CreativeInquiry/SCI-RAT-Attachments-for-UR5/README.md

# SCI-RAT-Attachments-for-UR5
A series of 3D-printable attachments for the UR5 robot arm, developed by the Frank Ratchye STUDIO for Creative Inquiry.

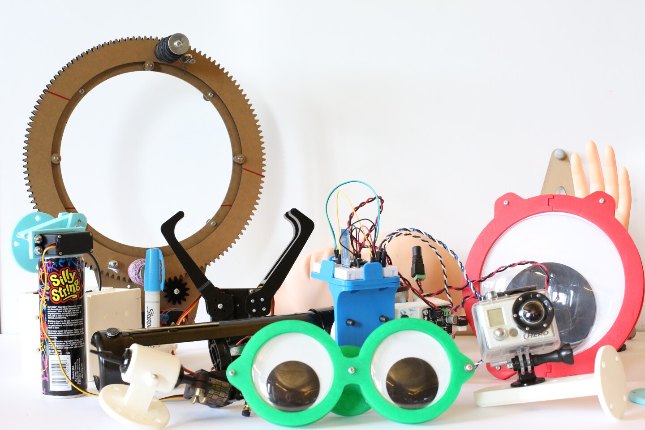
[picture p1: Images/lo_SCI-RAT.jpg]
Image of 15 Attachments


The following files are included for every adapter:
  * [.3dm] The original CAD files made in Rhino.
  * [.stl] Compatible with various 3D printing sofware.
  * [.x3g] Machine instructions for Makerbot Replicator 2.

All files are licensed under the [CC BY-SA 4.0 License](https://creativecommons.org/licenses/by-sa/4.0/).

Here is a full list of all attachments in this repository so far:

1. **Universal Mounts:**
  * [Rod Adapter](https://github.com/johnchoi313/SCI-RAT-Attachments-for-UR5/tree/master/Attachments/Universal%20Mounts/Rod%20Adapter)
  * [Camera Mount](https://github.com/johnchoi313/SCI-RAT-Attachments-for-UR5/tree/master/Attachments/Universal%20Mounts/Camera%20Mount)
2. **Electronics Platforms:**
  * [Breadboard Mount](https://github.com/johnchoi313/SCI-RAT-Attachments-for-UR5/tree/master/Attachments/Electronics%20Platforms/Breadboard%20Mount)
  * [Enclosed Arduino Cube](https://github.com/johnchoi313/SCI-RAT-Attachments-for-UR5/tree/master/Attachments/Electronics%20Platforms/Enclosed%20Arduino%20Cube)
3. **Googly Eyes:** 
  * [Googly Eye Double Mount](https://github.com/johnchoi313/SCI-RAT-Attachments-for-UR5/tree/master/Attachments/Googly%20Eyes)
  * [Googly Eye Single Mount](https://github.com/johnchoi313/SCI-RAT-Attachments-for-UR5/tree/master/Attachments/Googly%20Eyes)
4. **Tool Adapters:**
  * [Ryobi Caulk Gun Adapter](https://github.com/johnchoi313/SCI-RAT-Attachments-for-UR5/tree/master/Attachments/Tool%20Adapters/Ryobi%20Caulk%20Gun%20Adapter)
  * [Silly String Adapter](https://github.com/johnchoi313/SCI-RAT-Attachments-for-UR5/tree/master/Attachments/Tool%20Adapters/Silly%20String%20Adapter)
  * [Tattoo Adapter](https://github.com/johnchoi313/SCI-RAT-Attachments-for-UR5/tree/master/Attachments/Tool%20Adapters/Tattoo%20Adapter)
5. **Custom Hardware:**
  * [Threading Machine](https://github.com/johnchoi313/SCI-RAT-Attachments-for-UR5/tree/master/Attachments/Custom%20Hardware/Threading%20Hand)
  * [Gripper Mount](https://github.com/johnchoi313/SCI-RAT-Attachments-for-UR5/tree/master/Attachments/Custom%20Hardware/Gripper%20Mount)
  * [CV Effector](https://github.com/johnchoi313/SCI-RAT-Attachments-for-UR5/tree/master/Attachments/Custom%20Hardware/CV%20Effector)
6. **Body Parts:**
  * [Finger Mount](https://github.com/johnchoi313/SCI-RAT-Attachments-for-UR5/tree/master/Attachments/Body%20Parts/FingerMount)
  * [Hand Mount](https://github.com/johnchoi313/SCI-RAT-Attachments-for-UR5/tree/master/Attachments/Universal%20Mounts/Rod%20Adapter)
  * [Head Mount](https://github.com/johnchoi313/SCI-RAT-Attachments-for-UR5/tree/master/Attachments/Body%20Parts/Head%20Mount)

Detailed documentation of each attachment can be found in this [PDF Document](https://github.com/johnchoi313/SCI-RAT-Attachments-for-UR5/blob/master/SCI-RAT%20Adapters%202016.pdf).
