CreativeInquiry/SCI-RAT-Attachments-for-UR5/Attachments/Miscellaneous/Microscope Project/Microscope Slider.JPG

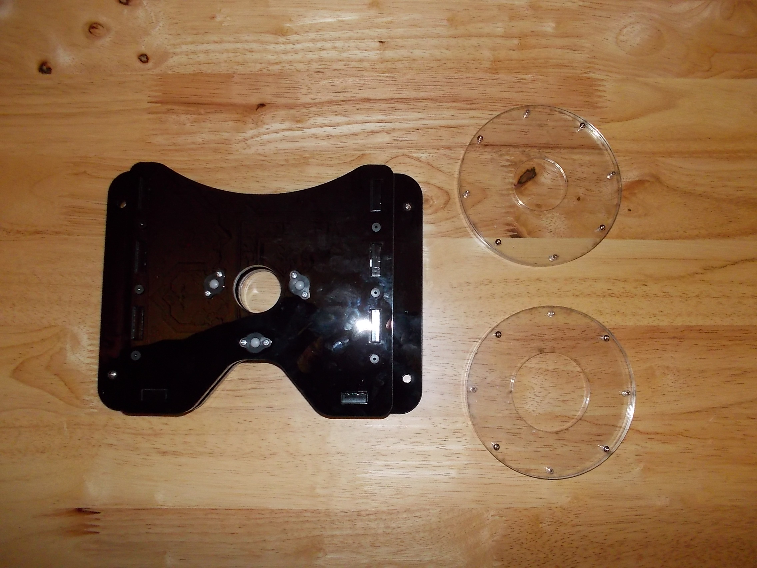
Attachments/Miscellaneous/Microscope Project/Microscope Slider.JPG
