CreativeInquiry/SCI-RAT-Attachments-for-UR5/Images/4x40.PNG

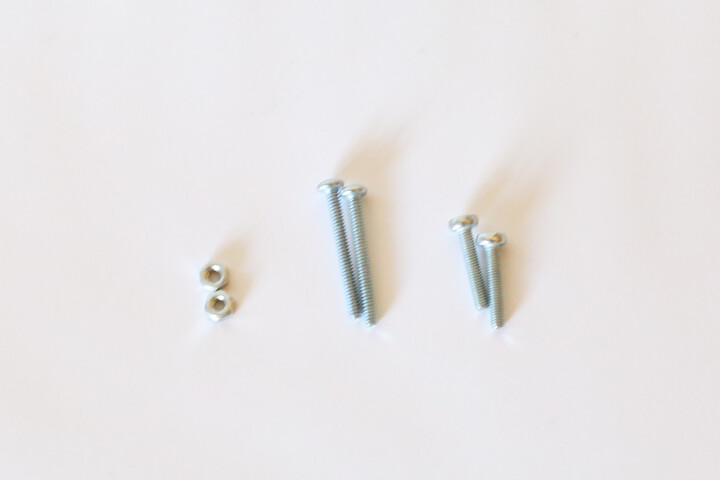
Images/4x40.PNG
