CreativeInquiry/SCI-RAT-Attachments-for-UR5/Images/lo_4-40.jpg

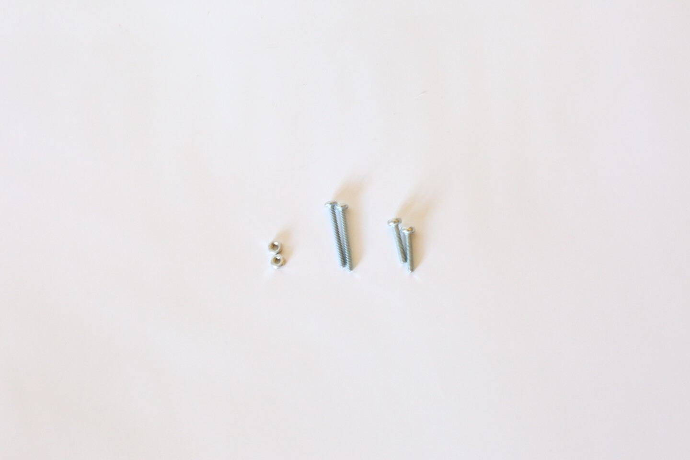
Images/lo_4-40.jpg
