CreativeInquiry/SCI-RAT-Attachments-for-UR5/Images/lo_ArduinoEnclosed (1).jpg

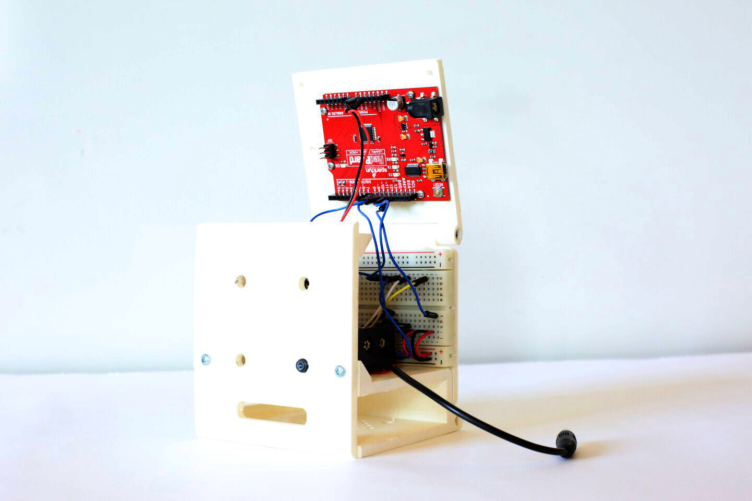
Images/lo_ArduinoEnclosed (1).jpg
