CreativeInquiry/SCI-RAT-Attachments-for-UR5/Images/lo_ArduinoEnclosed (2).jpg

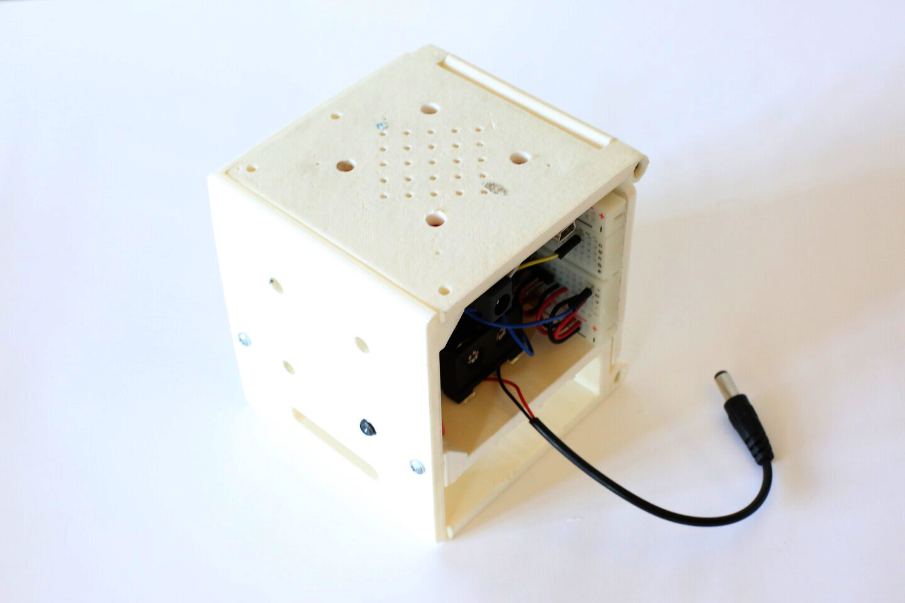
Images/lo_ArduinoEnclosed (2).jpg
