CreativeInquiry/SCI-RAT-Attachments-for-UR5/Images/lo_ArduinoEnclosed (5).jpg

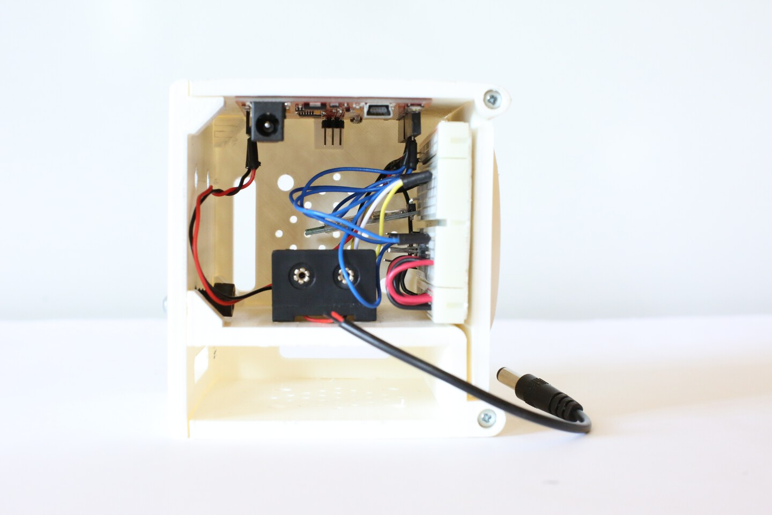
Images/lo_ArduinoEnclosed (5).jpg
