CreativeInquiry/SCI-RAT-Attachments-for-UR5/Images/lo_Breadboard (1).jpg

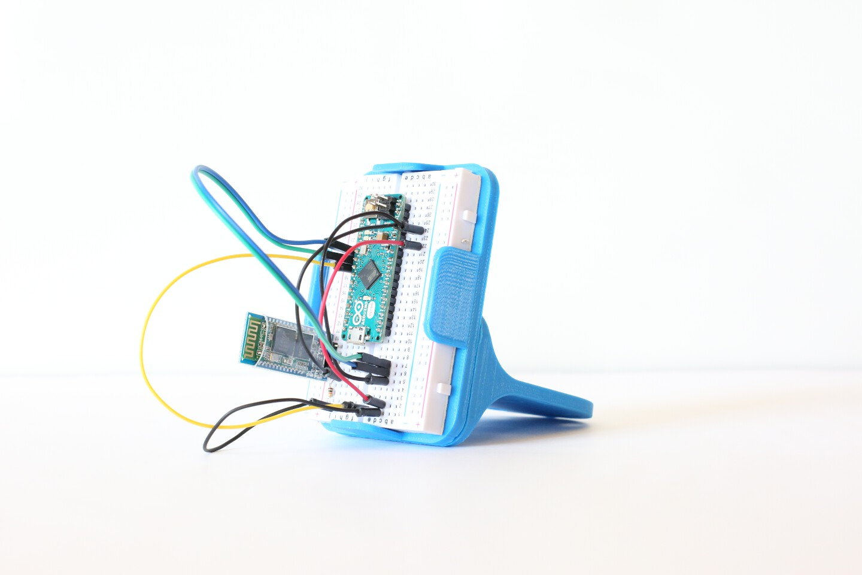
Images/lo_Breadboard (1).jpg
