CreativeInquiry/SCI-RAT-Attachments-for-UR5/Images/lo_Breadboard (2).jpg

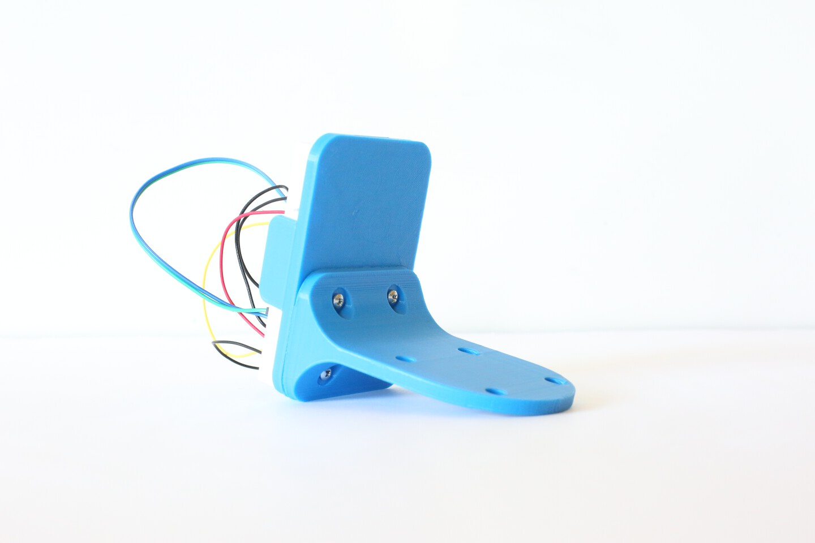
Images/lo_Breadboard (2).jpg
