CreativeInquiry/SCI-RAT-Attachments-for-UR5/Images/lo_Camera (1).jpg

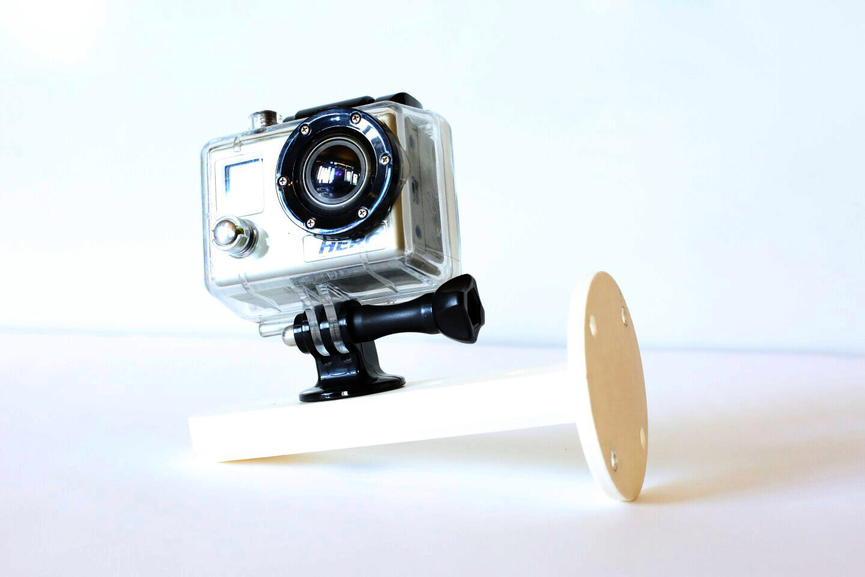
Images/lo_Camera (1).jpg
