CreativeInquiry/SCI-RAT-Attachments-for-UR5/Images/lo_Camera (2).jpg

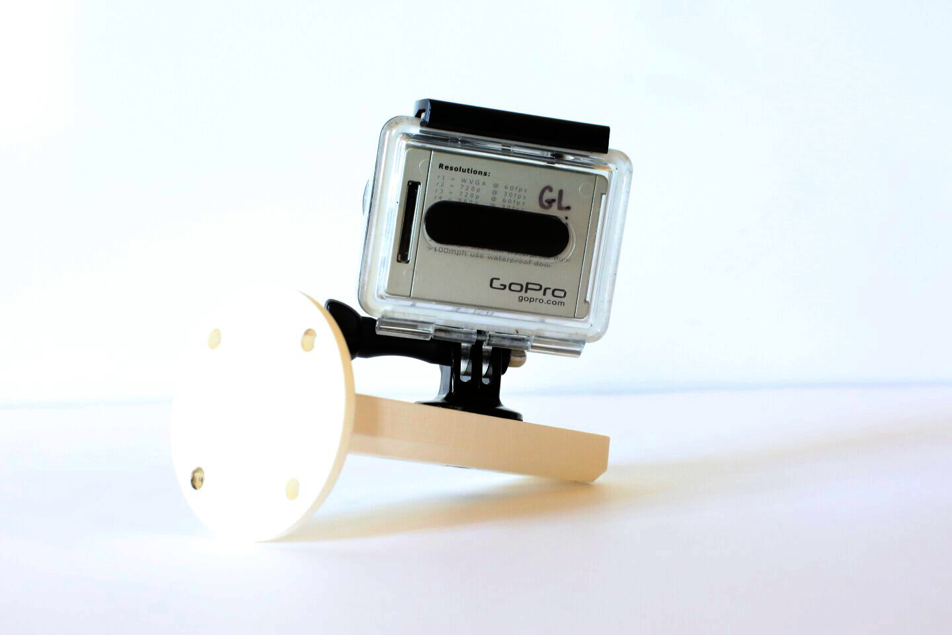
Images/lo_Camera (2).jpg
