CreativeInquiry/SCI-RAT-Attachments-for-UR5/Images/lo_CV (1).jpg

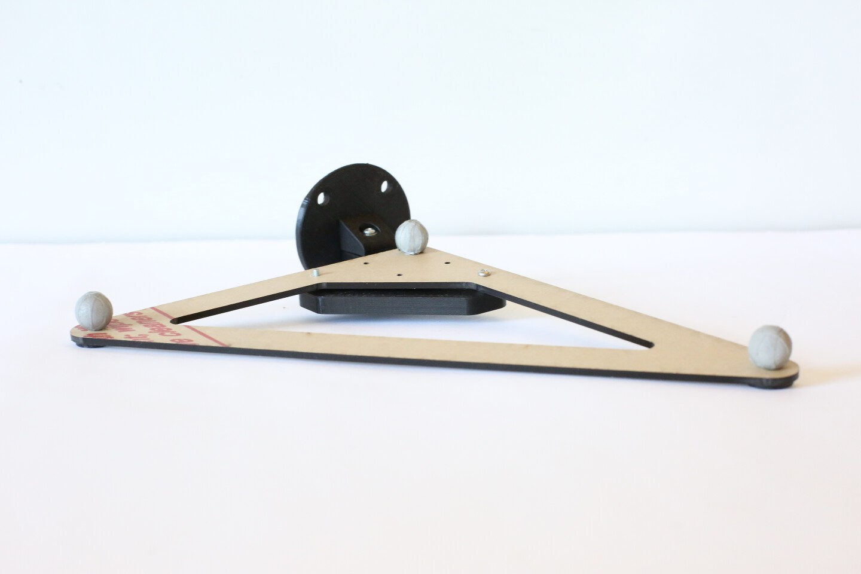
Images/lo_CV (1).jpg
