CreativeInquiry/SCI-RAT-Attachments-for-UR5/Images/lo_GooglyDouble (1).jpg

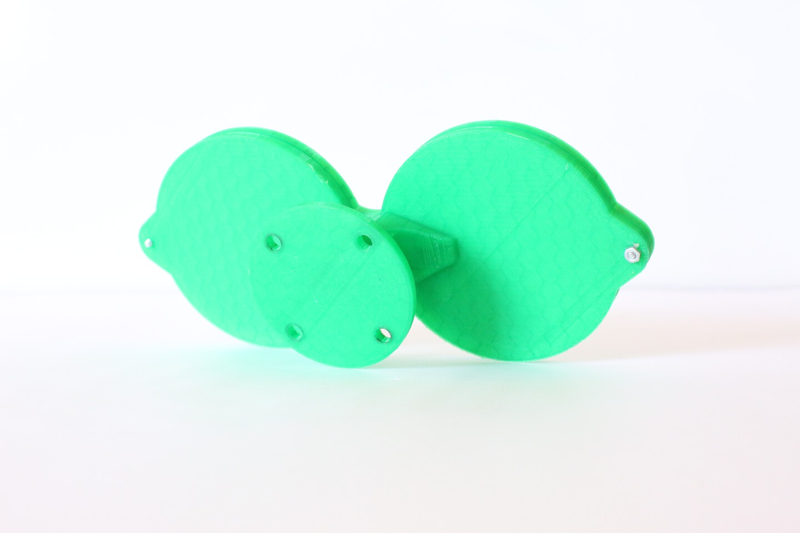
Images/lo_GooglyDouble (1).jpg
