CreativeInquiry/SCI-RAT-Attachments-for-UR5/Images/lo_GooglyDouble (2).jpg

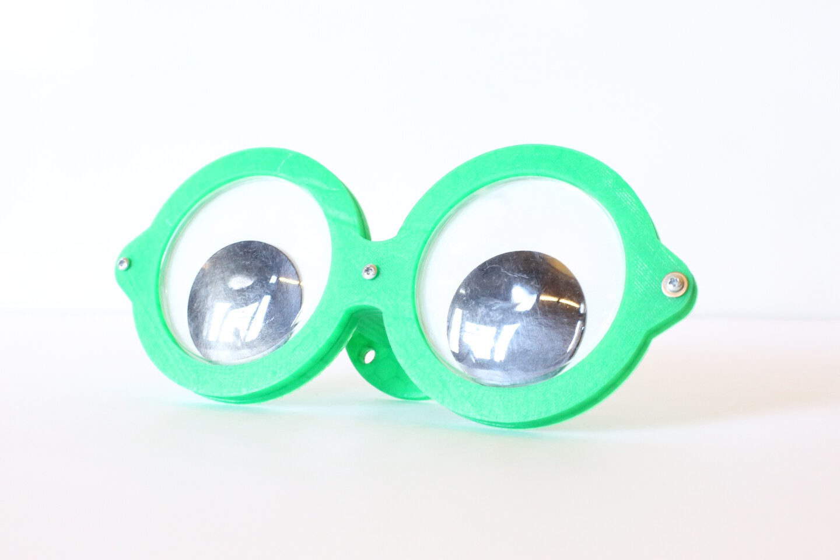
Images/lo_GooglyDouble (2).jpg
