CreativeInquiry/SCI-RAT-Attachments-for-UR5/Images/lo_GooglySingle (2).jpg

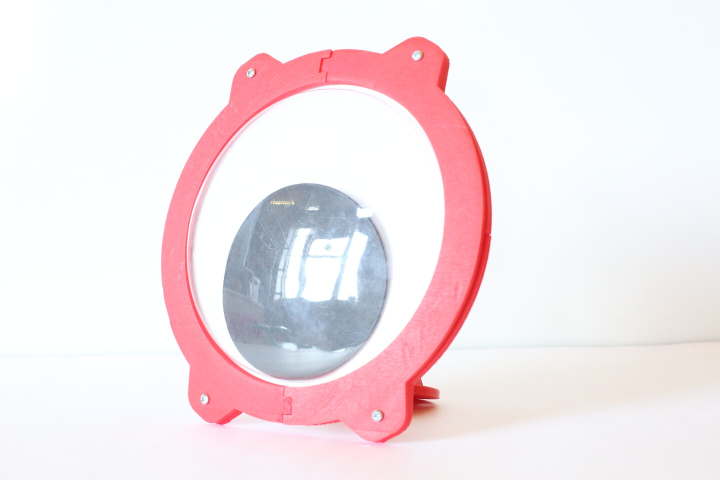
Images/lo_GooglySingle (2).jpg
