CreativeInquiry/SCI-RAT-Attachments-for-UR5/Images/lo_GooglyVR (3).jpg

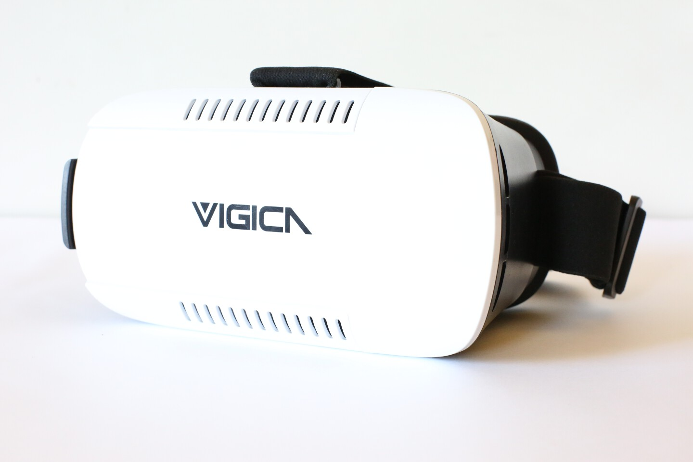
Images/lo_GooglyVR (3).jpg
