CreativeInquiry/SCI-RAT-Attachments-for-UR5/Images/lo_GooglyVR (4).jpg

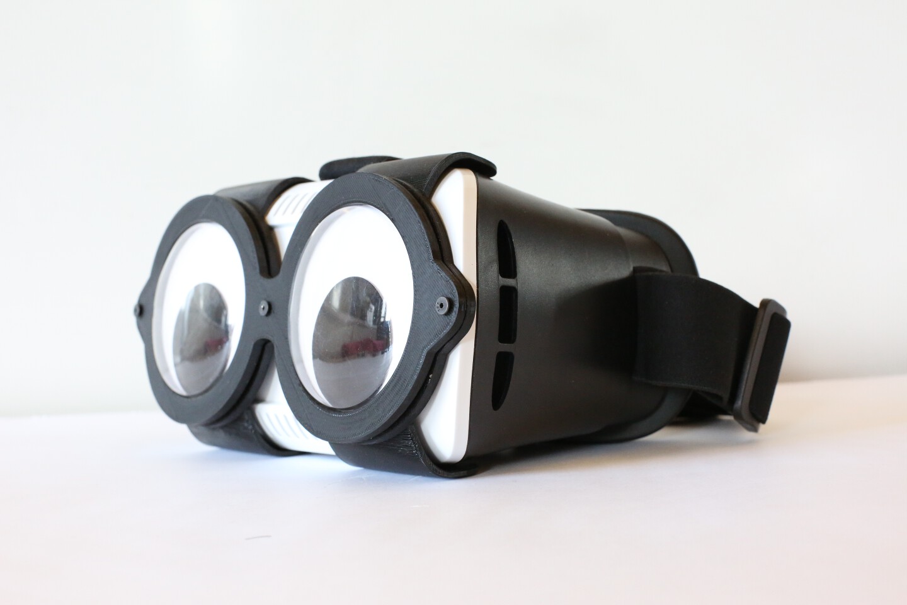
Images/lo_GooglyVR (4).jpg
