CreativeInquiry/SCI-RAT-Attachments-for-UR5/Images/lo_Gripper (1).jpg

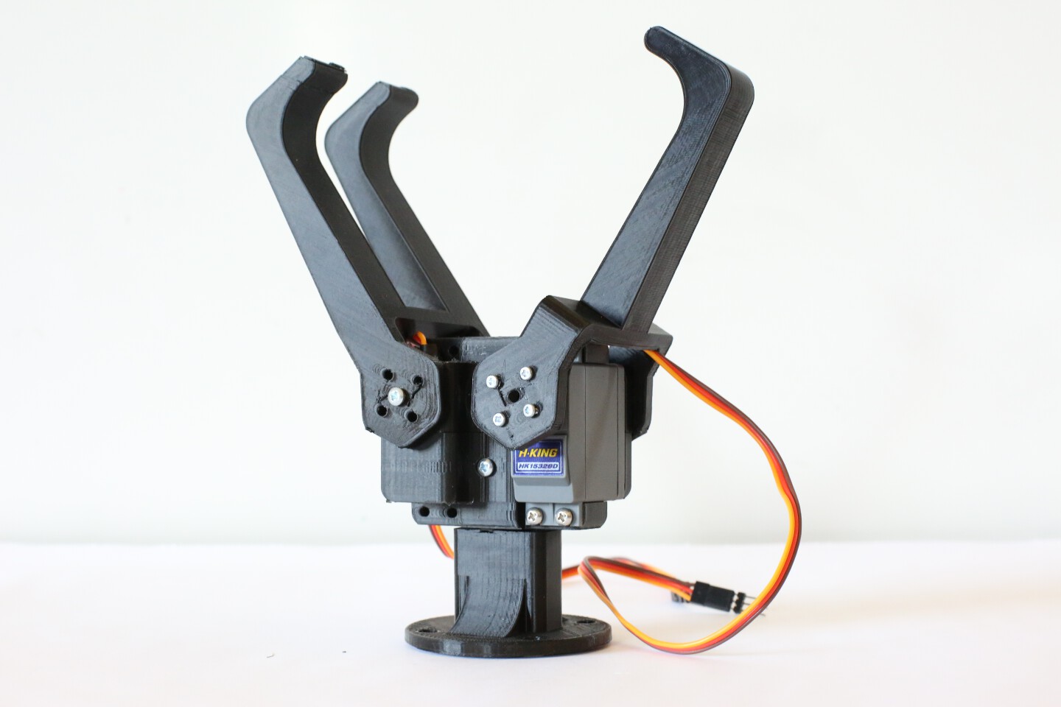
Images/lo_Gripper (1).jpg
