CreativeInquiry/SCI-RAT-Attachments-for-UR5/Images/lo_Hand (1).jpg

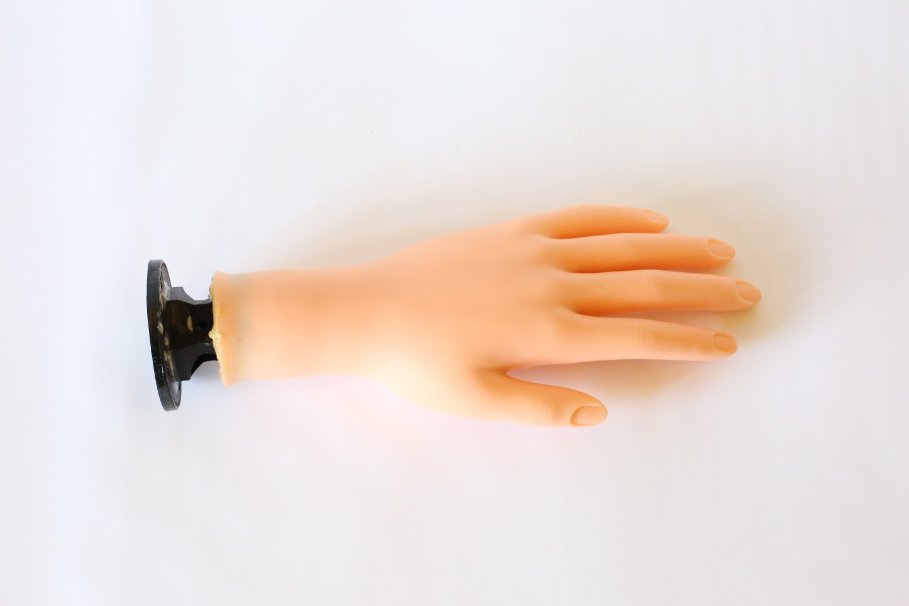
Images/lo_Hand (1).jpg
