CreativeInquiry/SCI-RAT-Attachments-for-UR5/Images/lo_Hand (2).jpg

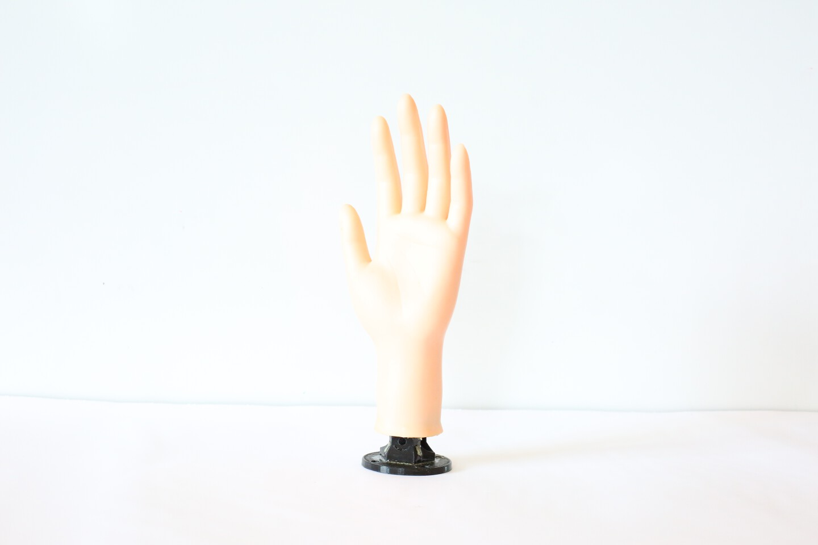
Images/lo_Hand (2).jpg
