CreativeInquiry/SCI-RAT-Attachments-for-UR5/Images/lo_Head (2).jpg

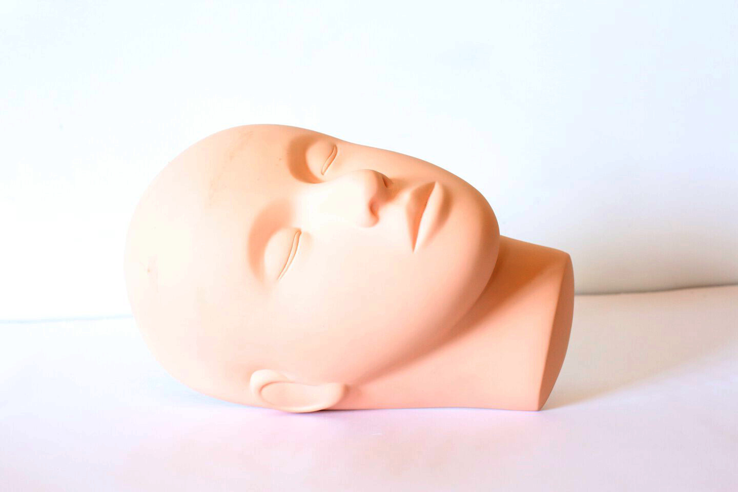
Images/lo_Head (2).jpg
