CreativeInquiry/SCI-RAT-Attachments-for-UR5/Images/lo_Ryobi (2).jpg

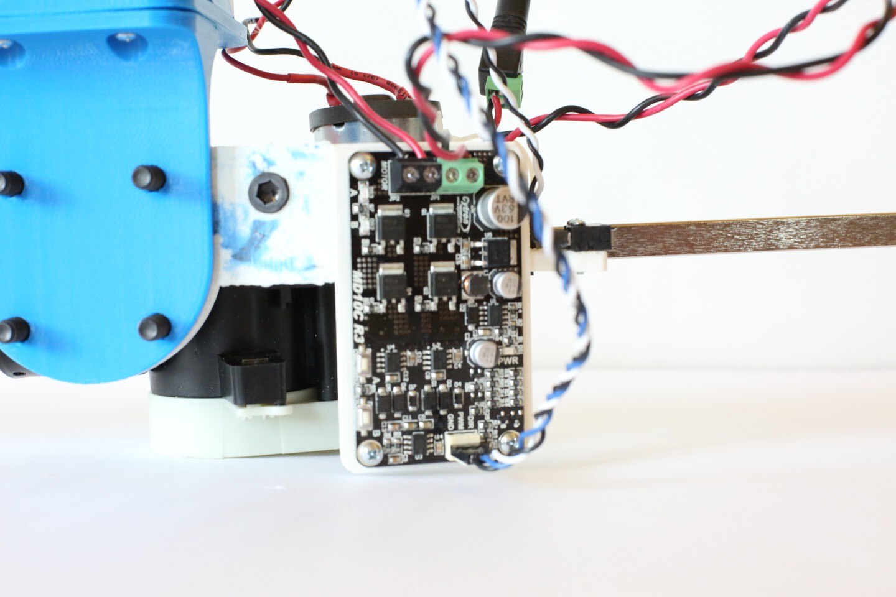
Images/lo_Ryobi (2).jpg
