CreativeInquiry/SCI-RAT-Attachments-for-UR5/Images/lo_Ryobi (3).jpg

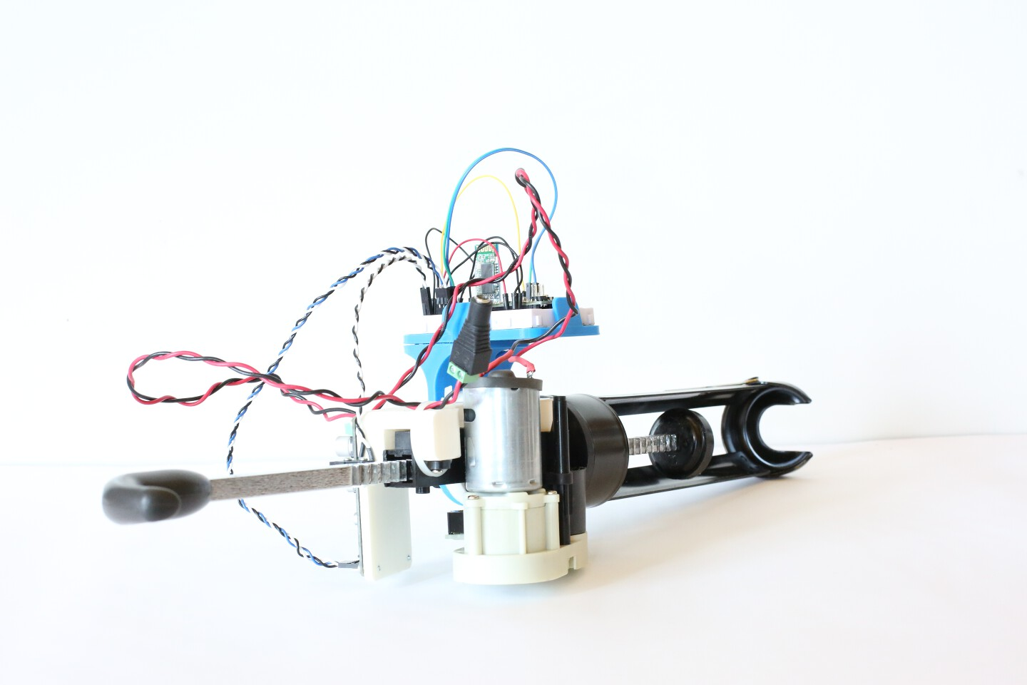
Images/lo_Ryobi (3).jpg
