CreativeInquiry/SCI-RAT-Attachments-for-UR5/Images/lo_SillyString (1).jpg

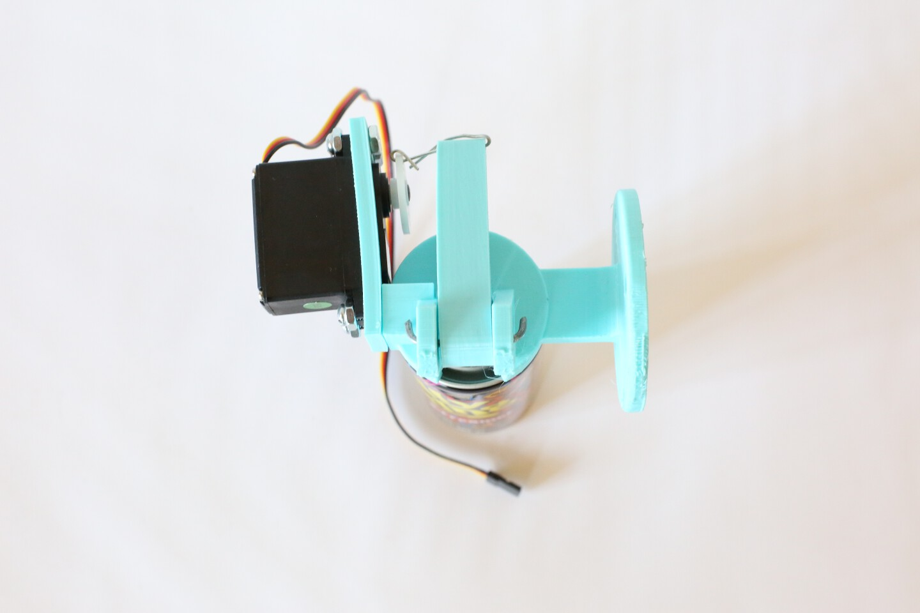
Images/lo_SillyString (1).jpg
