CreativeInquiry/SCI-RAT-Attachments-for-UR5/Images/lo_SillyString (2).jpg

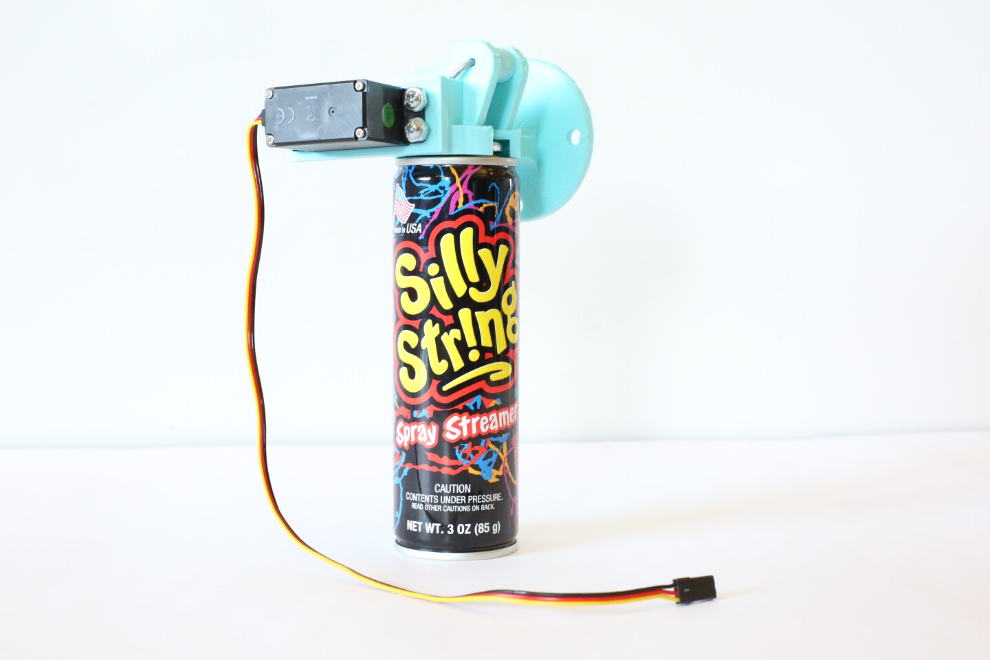
Images/lo_SillyString (2).jpg
