CreativeInquiry/SCI-RAT-Attachments-for-UR5/Images/lo_Tattoo (2).jpg

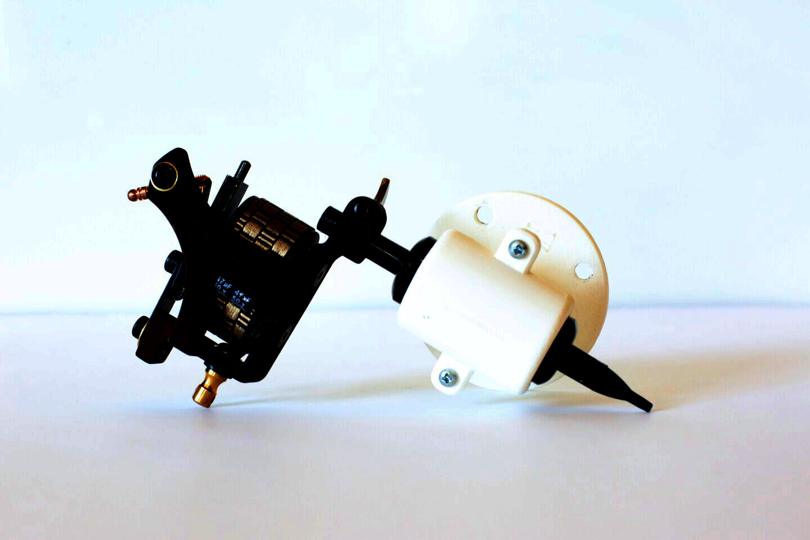
Images/lo_Tattoo (2).jpg
