CreativeInquiry/SCI-RAT-Attachments-for-UR5/Images/lo_Threading (2).jpg

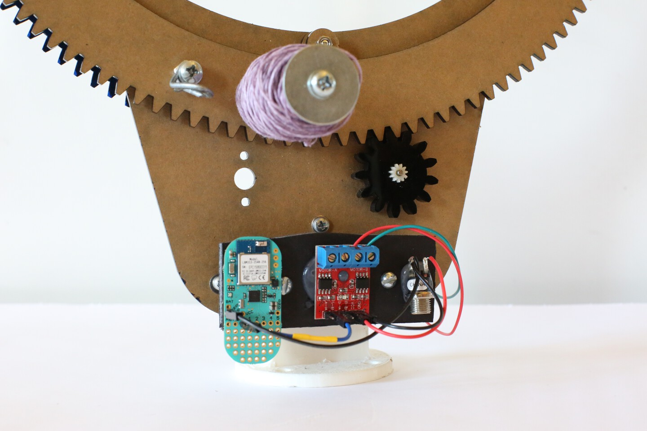
Images/lo_Threading (2).jpg
