CreativeInquiry/SCI-RAT-Attachments-for-UR5/Images/lo_Thumb (1).jpg

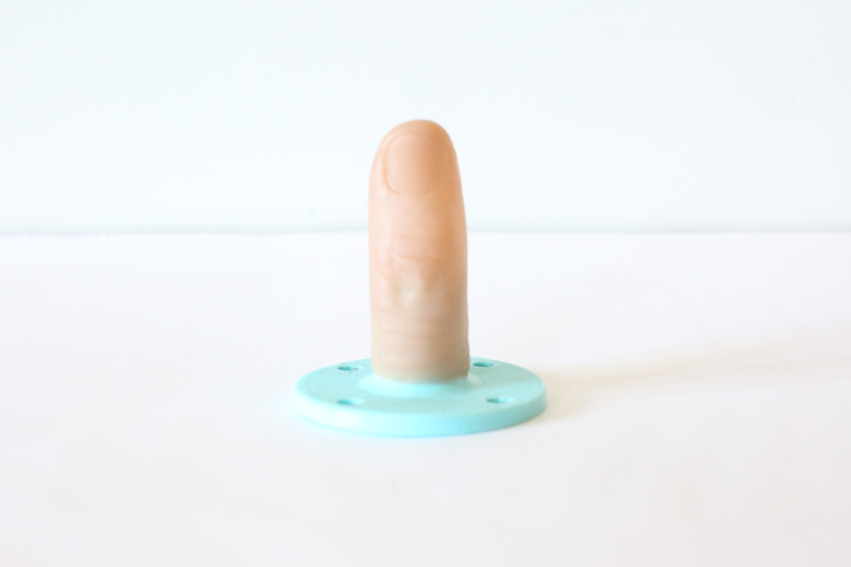
Images/lo_Thumb (1).jpg
