CreativeInquiry/SCI-RAT-Attachments-for-UR5/Images/lo_Universal (1).jpg

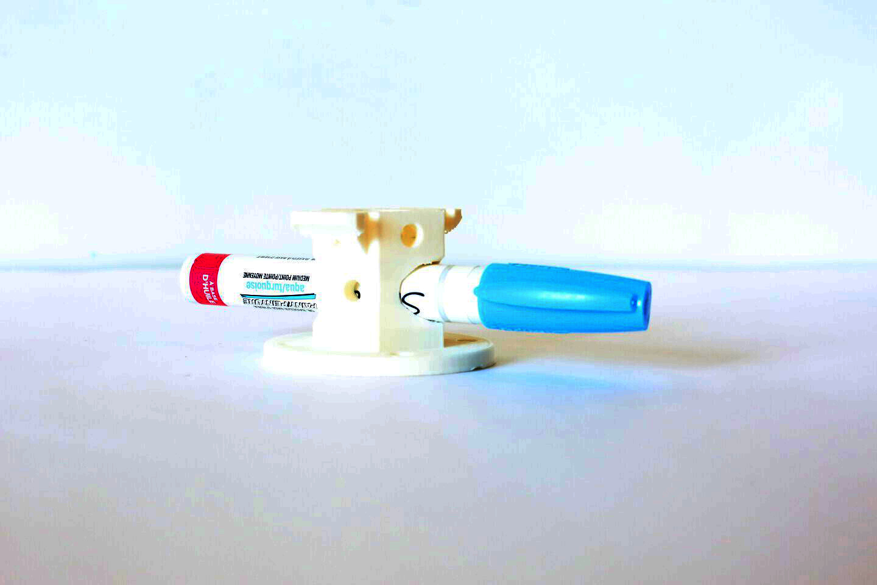
Images/lo_Universal (1).jpg
