CreativeInquiry/SCI-RAT-Attachments-for-UR5/Images/m6x12.JPG

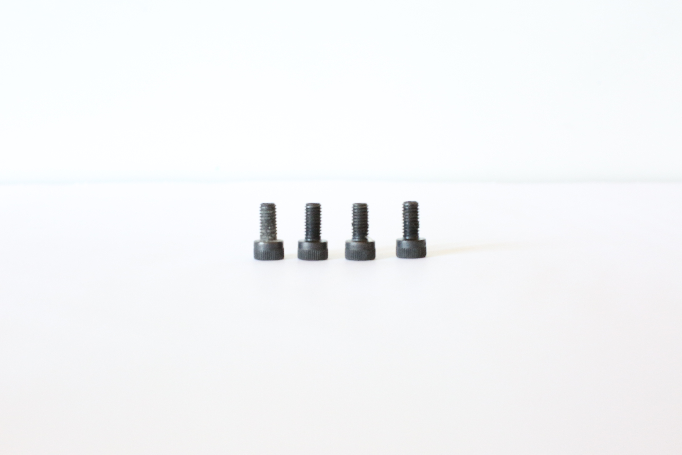
Images/m6x12.JPG
