CreativeInquiry/SCI-RAT-Attachments-for-UR5/Images/M6x12.PNG

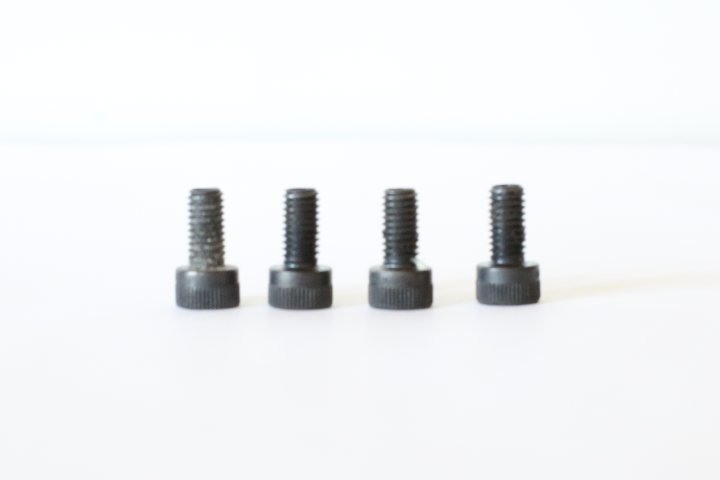
Images/M6x12.PNG
