CreativeInquiry/SCI-RAT-Attachments-for-UR5/Attachments/Body Parts/FingerMount/Finger.stl

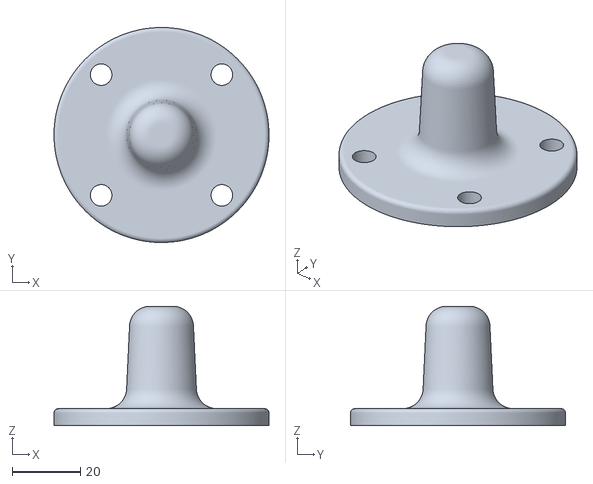
[picture p63: CAD file, 2016-05-16]
Attachments/Body Parts/FingerMount/Finger.stl
63.0 x 63.0 x 35.0
