CreativeInquiry/SCI-RAT-Attachments-for-UR5/Attachments/Body Parts/Head Mount/HeadAdapter2.stl

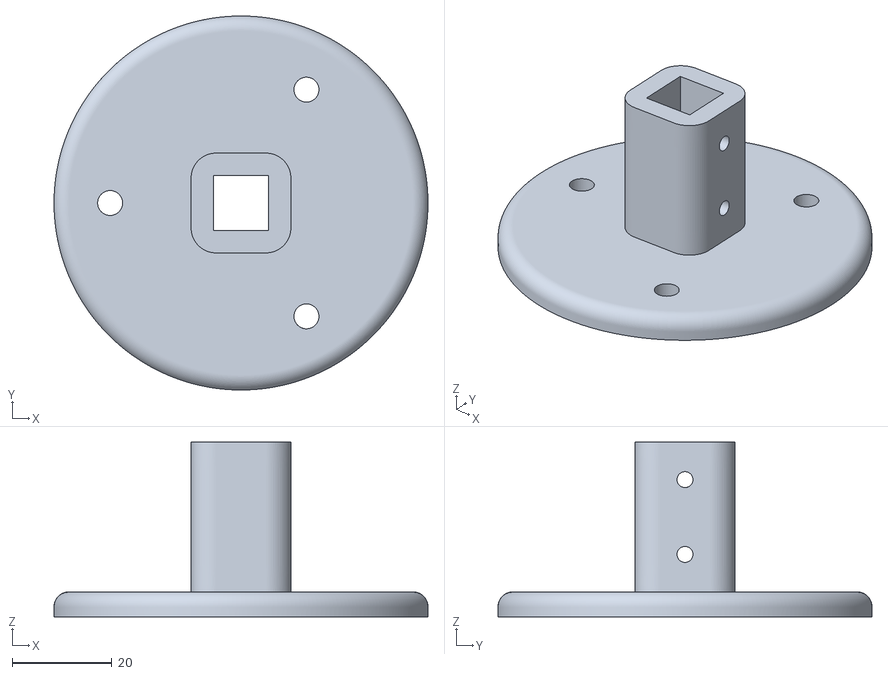
[picture p64: CAD file, 2016-05-16]
Attachments/Body Parts/Head Mount/HeadAdapter2.stl
75.0 x 75.0 x 35.0
