CreativeInquiry/SCI-RAT-Attachments-for-UR5/Attachments/Custom Hardware/CV Effector/CV2.stl

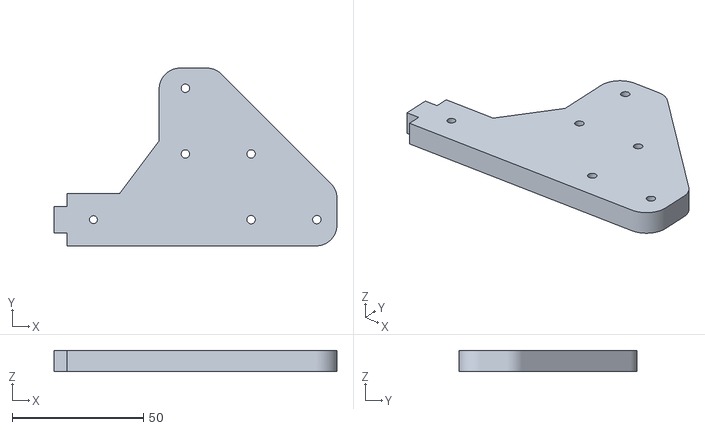
[picture p65: CAD file, 2016-05-16]
Attachments/Custom Hardware/CV Effector/CV2.stl
107.7 x 67.7 x 8.00
