CreativeInquiry/SCI-RAT-Attachments-for-UR5/Attachments/Custom Hardware/Gripper Mount/GripperServoHolder1.stl

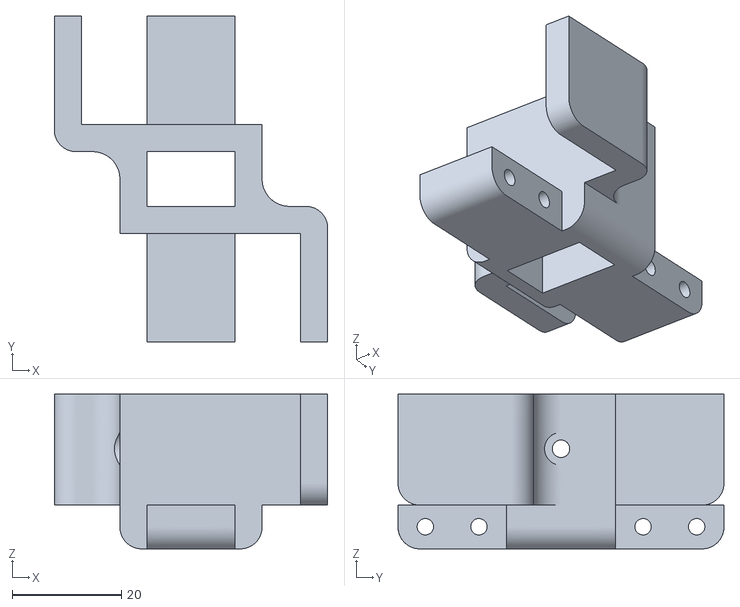
[picture p66: CAD file, 2016-05-16]
Attachments/Custom Hardware/Gripper Mount/GripperServoHolder1.stl
50.0 x 59.6 x 28.3
