CreativeInquiry/SCI-RAT-Attachments-for-UR5/Attachments/Electronics Platforms/Breadboard Mount/BreadboardMount_2.stl

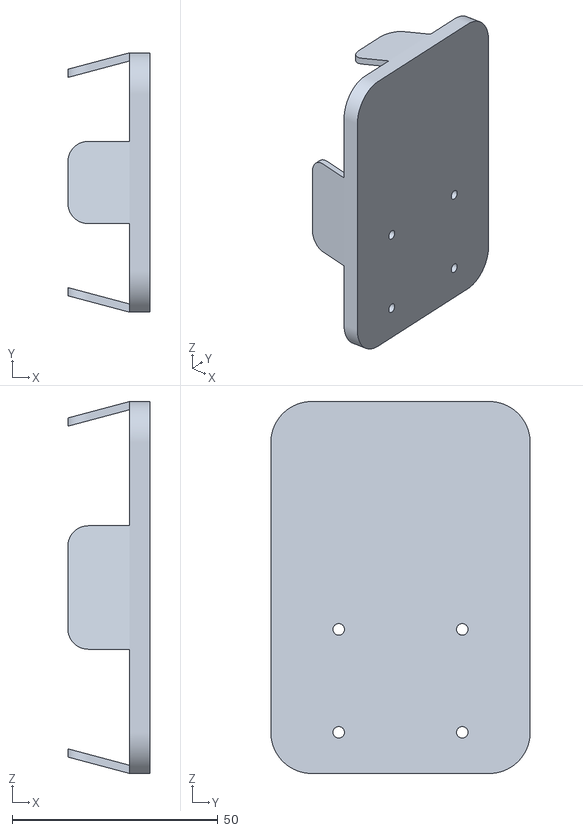
[picture p67: CAD file, 2016-05-16]
Attachments/Electronics Platforms/Breadboard Mount/BreadboardMount_2.stl
20.0 x 63.0 x 90.3
