CreativeInquiry/SCI-RAT-Attachments-for-UR5/Attachments/Electronics Platforms/Enclosed Arduino Cube/ArduinoMount_4.stl

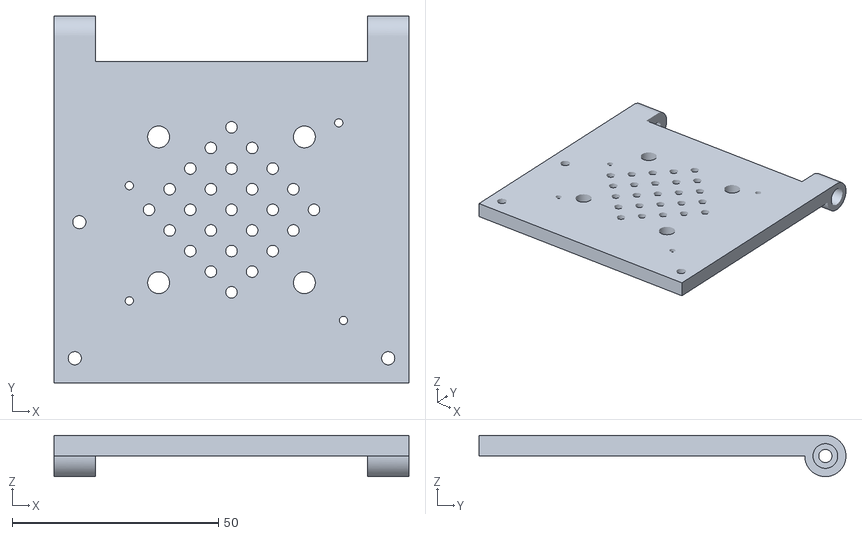
[picture p68: CAD file, 2016-05-16]
Attachments/Electronics Platforms/Enclosed Arduino Cube/ArduinoMount_4.stl
86.0 x 89.0 x 10.0
