CreativeInquiry/SCI-RAT-Attachments-for-UR5/Attachments/Googly Eyes/BigEye1_4.stl

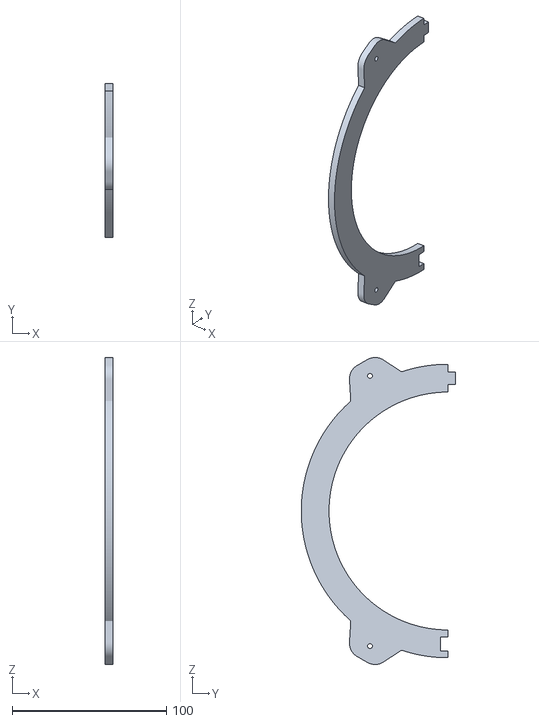
[picture p69: CAD file, 2016-05-16]
Attachments/Googly Eyes/BigEye1_4.stl
5.00 x 100.0 x 198.7
