CreativeInquiry/SCI-RAT-Attachments-for-UR5/Attachments/Miscellaneous/Microscope Project/wedge.stl

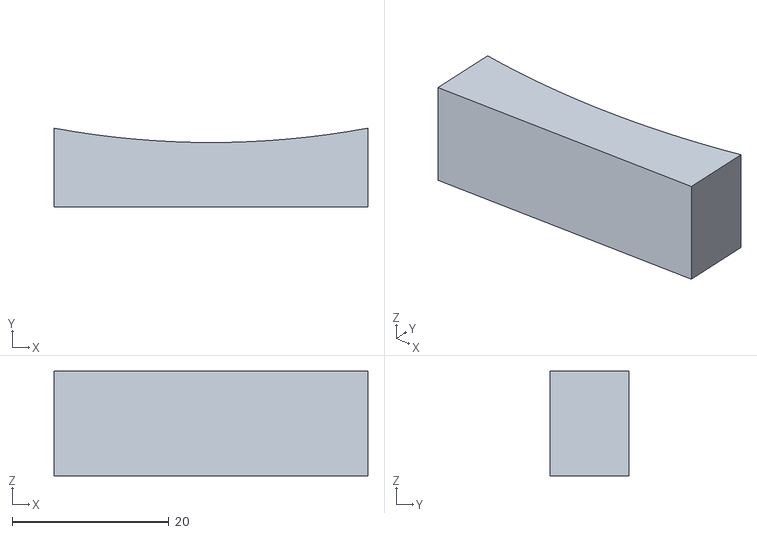
[picture p70: CAD file, 2016-05-16]
Attachments/Miscellaneous/Microscope Project/wedge.stl
40.0 x 10.0 x 13.3
