CreativeInquiry/SCI-RAT-Attachments-for-UR5/Attachments/Miscellaneous/New Aluminum Mounting PLate/3030-S-1-CL.stp

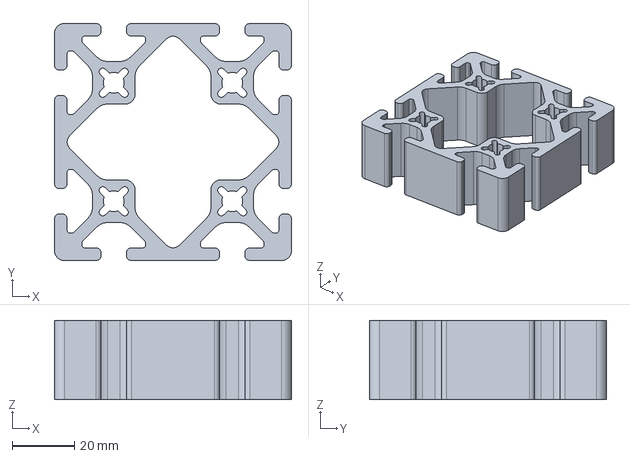
[picture p71: CAD file, 2016-05-16]
Attachments/Miscellaneous/New Aluminum Mounting PLate/3030-S-1-CL.stp
76.2 x 76.2 x 25.4 mm
