CreativeInquiry/SCI-RAT-Attachments-for-UR5/Attachments/Miscellaneous/VR Googly Eyes/VR Googly Eyes 2.stl

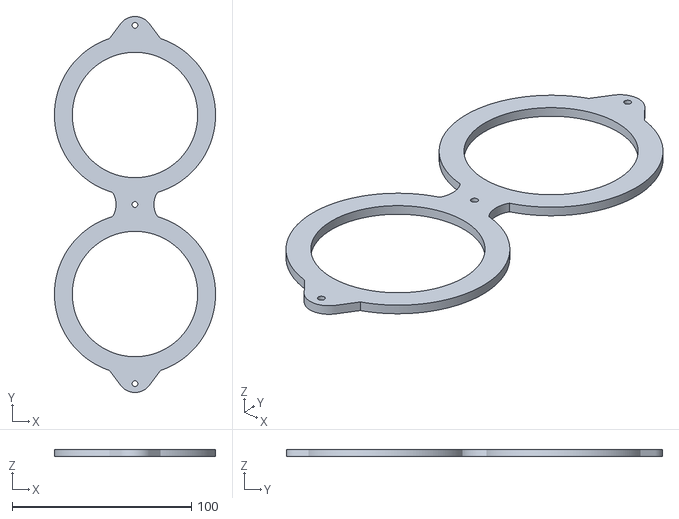
[picture p72: CAD file, 2016-05-16]
Attachments/Miscellaneous/VR Googly Eyes/VR Googly Eyes 2.stl
90.0 x 210.0 x 4.00
