CreativeInquiry/SCI-RAT-Attachments-for-UR5/Attachments/Tool Adapters/Ryobi Caulk Gun Adapter/RyobiMount_1.stl

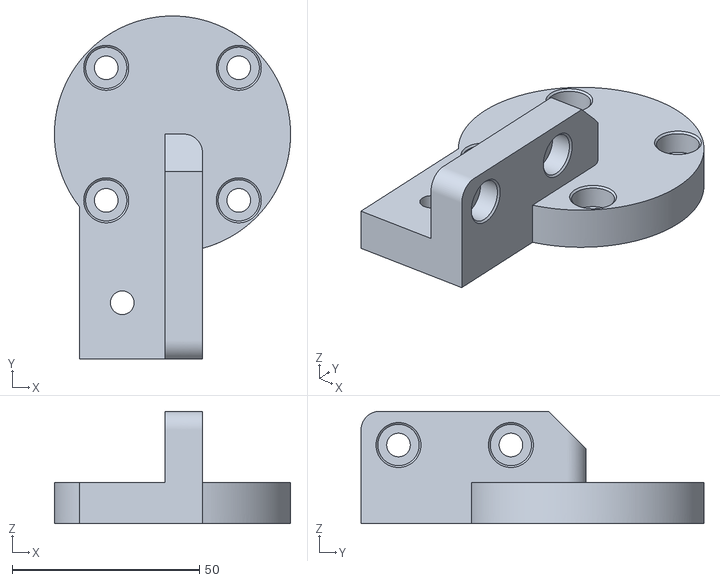
[picture p73: CAD file, 2016-05-16]
Attachments/Tool Adapters/Ryobi Caulk Gun Adapter/RyobiMount_1.stl
63.0 x 91.5 x 30.0
