CreativeInquiry/SCI-RAT-Attachments-for-UR5/Attachments/Tool Adapters/Silly String Adapter/Servo_controlled_Silly-String_Trigger 2/servoplate.stl

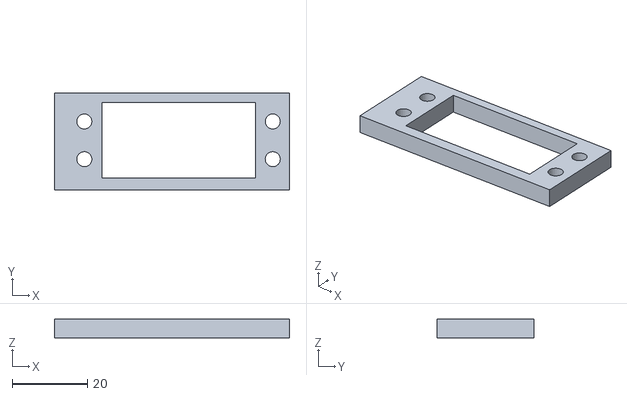
[picture p74: CAD file, 2016-05-16]
Attachments/Tool Adapters/Silly String Adapter/Servo_controlled_Silly-String_Trigger 2/servoplate.stl
62.4 x 25.8 x 5.00
