CreativeInquiry/SCI-RAT-Attachments-for-UR5/Attachments/Tool Adapters/Tattoo Adapter/TattooAdapter1.stl

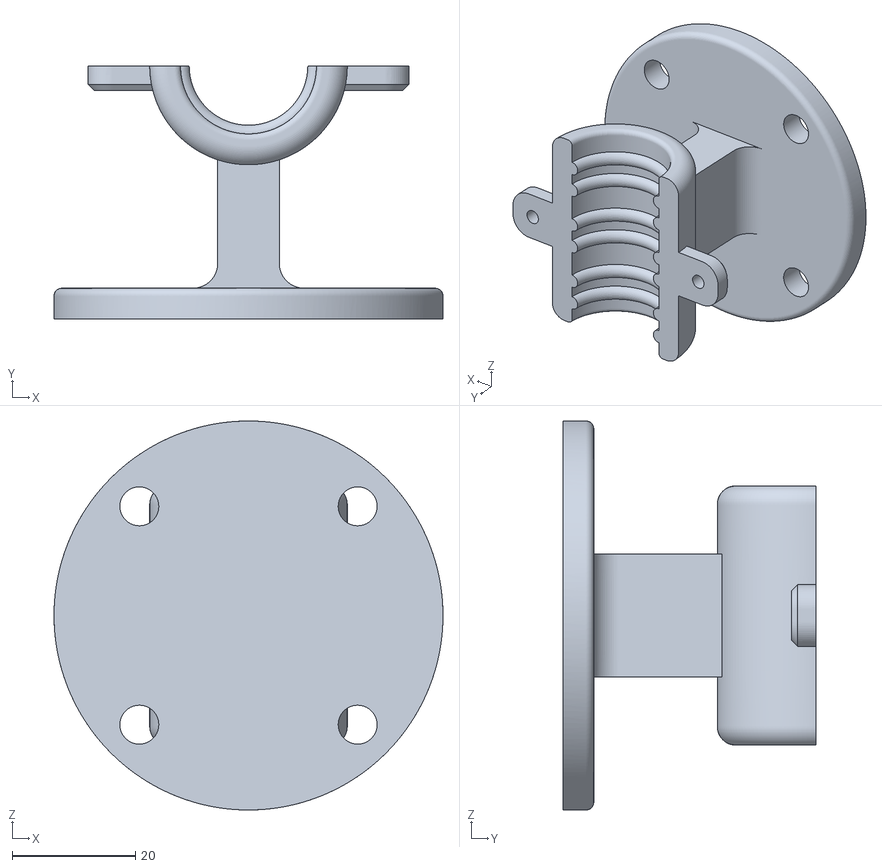
[picture p75: CAD file, 2016-05-16]
Attachments/Tool Adapters/Tattoo Adapter/TattooAdapter1.stl
63.0 x 41.0 x 63.0
