CreativeInquiry/SCI-RAT-Attachments-for-UR5/Attachments/Universal Mounts/Rod Adapter/Rod Adapter.stl

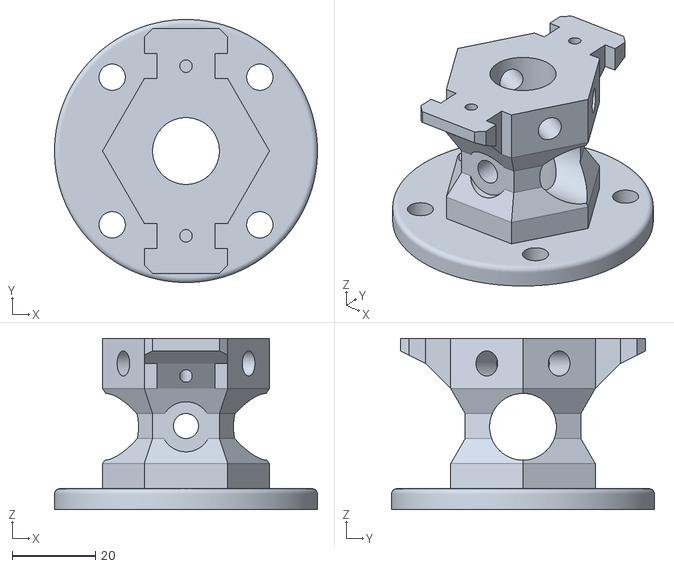
[picture p76: CAD file, 2016-05-16]
Attachments/Universal Mounts/Rod Adapter/Rod Adapter.stl
63.0 x 63.0 x 41.0
