CreativeInquiry/SCI-RAT-Attachments-for-UR5/Attachments/Body Parts/Head Mount/HeadAdapter1.stl

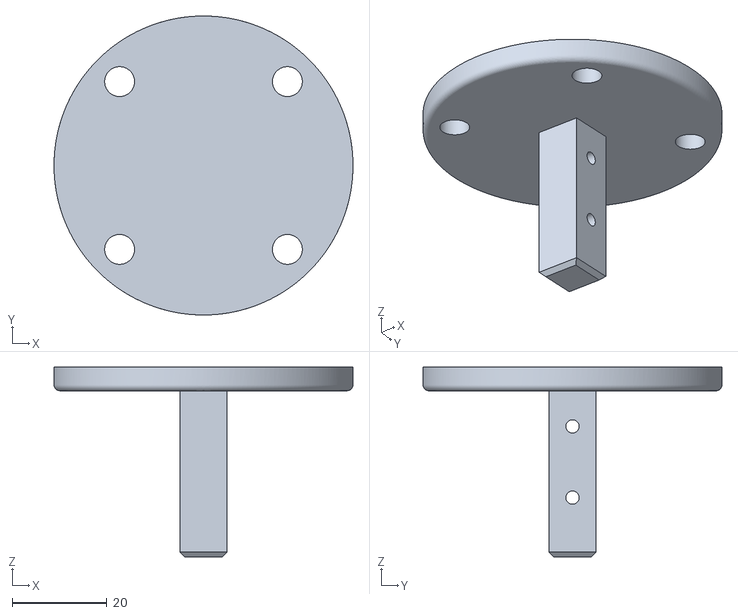
[picture p77: CAD file, 2016-05-16]
Attachments/Body Parts/Head Mount/HeadAdapter1.stl
63.0 x 63.0 x 40.0
