CreativeInquiry/SCI-RAT-Attachments-for-UR5/Attachments/Custom Hardware/CV Effector/CV1.stl

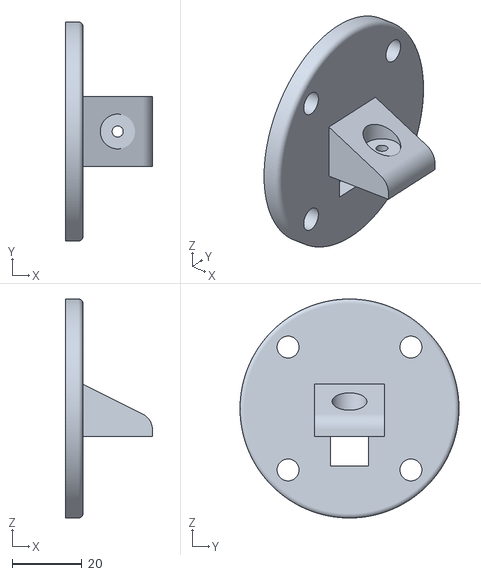
[picture p78: CAD file, 2016-05-16]
Attachments/Custom Hardware/CV Effector/CV1.stl
25.0 x 63.0 x 63.0
