CreativeInquiry/SCI-RAT-Attachments-for-UR5/Attachments/Electronics Platforms/Breadboard Mount/BreadboardMount_1.stl

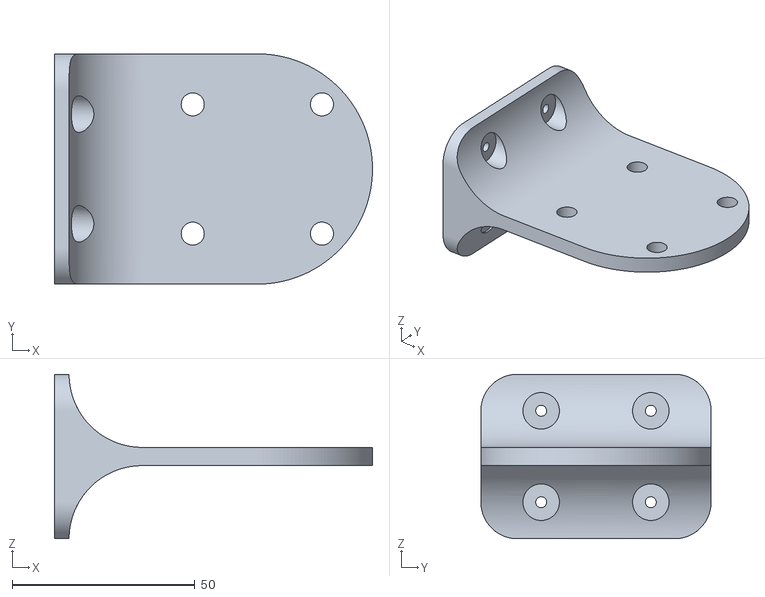
[picture p79: CAD file, 2016-05-16]
Attachments/Electronics Platforms/Breadboard Mount/BreadboardMount_1.stl
87.0 x 63.0 x 45.0
