CreativeInquiry/SCI-RAT-Attachments-for-UR5/Attachments/Electronics Platforms/Enclosed Arduino Cube/ArduinoMount_3.stl

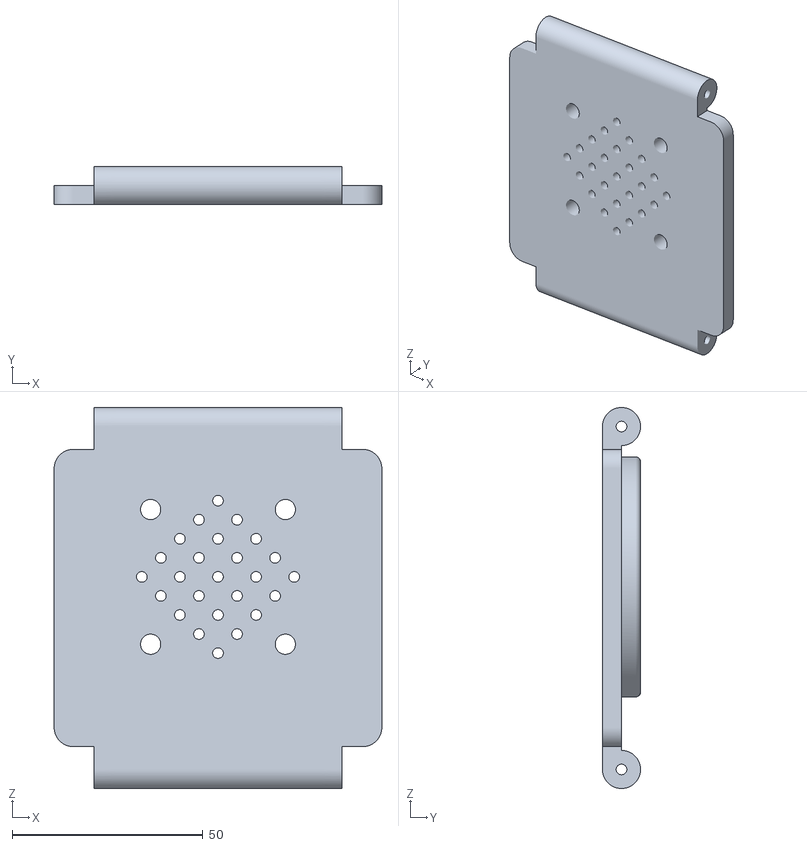
[picture p80: CAD file, 2016-05-16]
Attachments/Electronics Platforms/Enclosed Arduino Cube/ArduinoMount_3.stl
86.0 x 10.0 x 100.0
