CreativeInquiry/SCI-RAT-Attachments-for-UR5/Attachments/Googly Eyes/GooglyEye2_2.stl

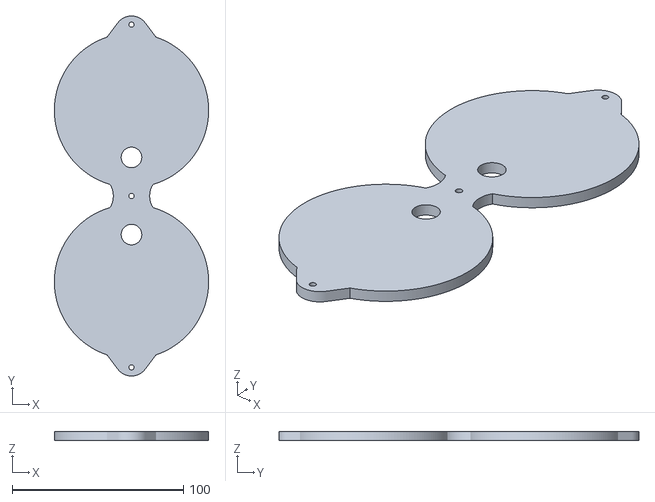
[picture p81: CAD file, 2016-05-16]
Attachments/Googly Eyes/GooglyEye2_2.stl
90.0 x 210.0 x 5.00
