CreativeInquiry/SCI-RAT-Attachments-for-UR5/Attachments/Miscellaneous/Microscope Project/1_4_BlackSheet.dxf

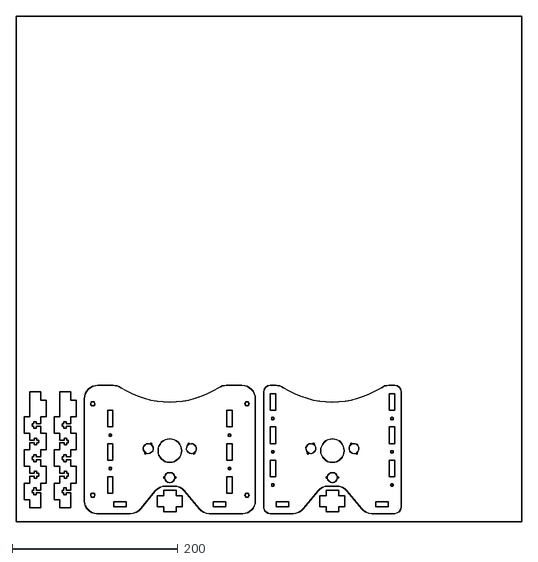
[picture p82: CAD file, 2016-05-16]
Attachments/Miscellaneous/Microscope Project/1_4_BlackSheet.dxf
609.6 x 609.6
