CreativeInquiry/SCI-RAT-Attachments-for-UR5/Attachments/Miscellaneous/New Aluminum Mounting PLate/BasePlate.stp

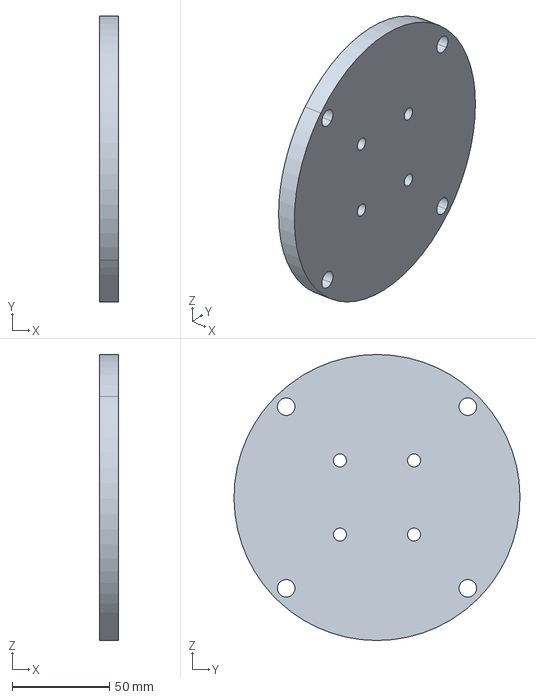
[picture p83: CAD file, 2016-05-16]
Attachments/Miscellaneous/New Aluminum Mounting PLate/BasePlate.stp
10.0 x 147.0 x 147.0 mm
