CreativeInquiry/SCI-RAT-Attachments-for-UR5/Attachments/Miscellaneous/VR Googly Eyes/VR Googly Eyes 1.stl

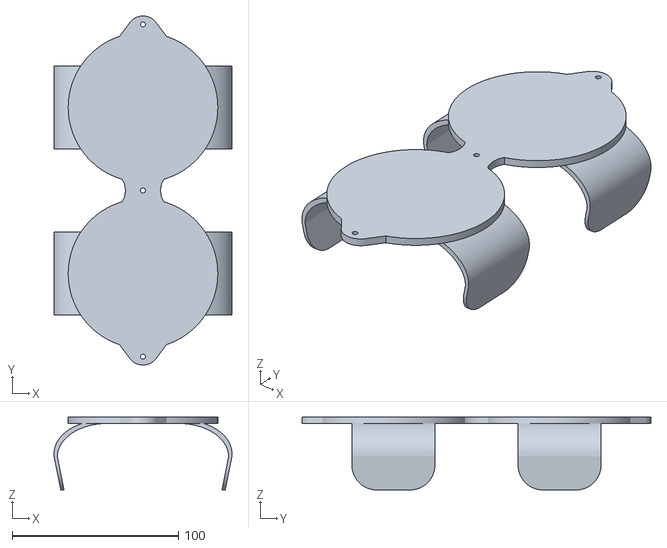
[picture p84: CAD file, 2016-05-16]
Attachments/Miscellaneous/VR Googly Eyes/VR Googly Eyes 1.stl
107.0 x 210.0 x 43.9
