CreativeInquiry/SCI-RAT-Attachments-for-UR5/Attachments/Tool Adapters/Ryobi Caulk Gun Adapter/RyobiMount_2.stl

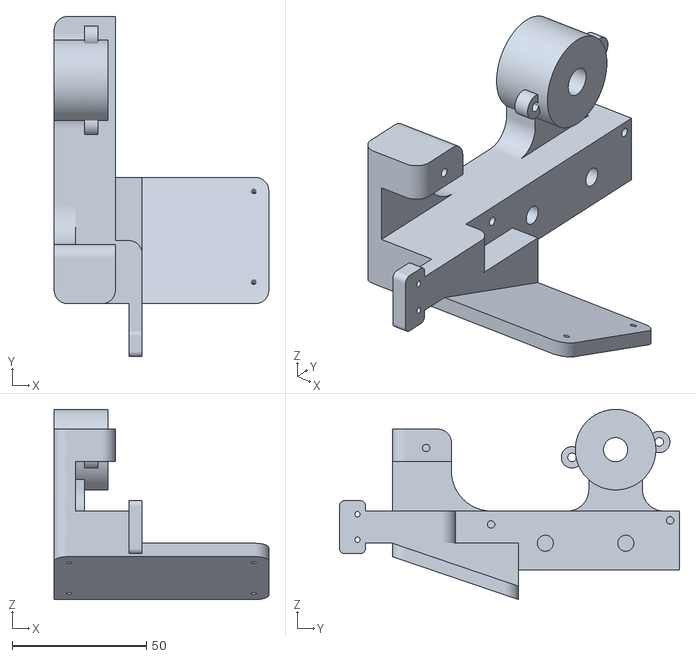
[picture p85: CAD file, 2016-05-16]
Attachments/Tool Adapters/Ryobi Caulk Gun Adapter/RyobiMount_2.stl
80.0 x 126.7 x 70.9
