CreativeInquiry/SCI-RAT-Attachments-for-UR5/Attachments/Tool Adapters/Silly String Adapter/Servo_controlled_Silly-String_Trigger 2/trigger.stl

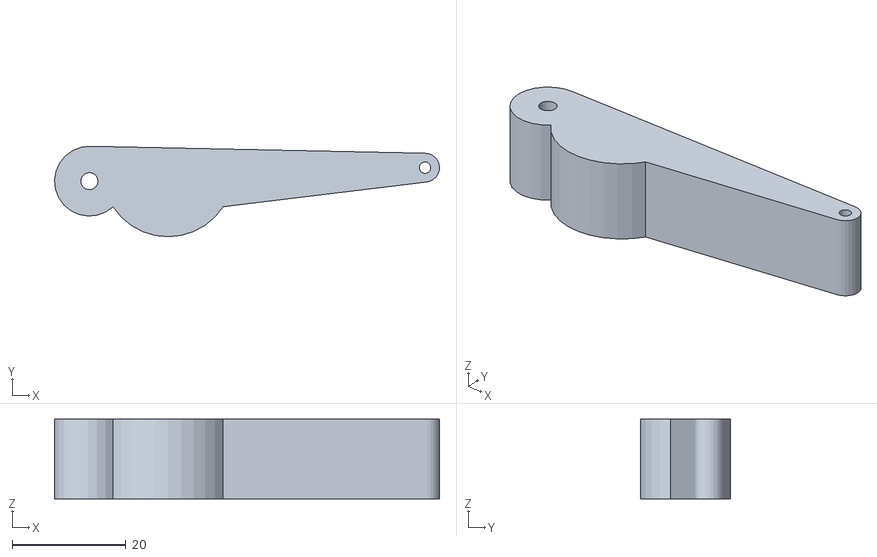
[picture p86: CAD file, 2016-05-16]
Attachments/Tool Adapters/Silly String Adapter/Servo_controlled_Silly-String_Trigger 2/trigger.stl
67.8 x 15.9 x 14.0
