CreativeInquiry/SCI-RAT-Attachments-for-UR5/Attachments/Tool Adapters/Silly String Adapter/SillyStringAdapter2.obj

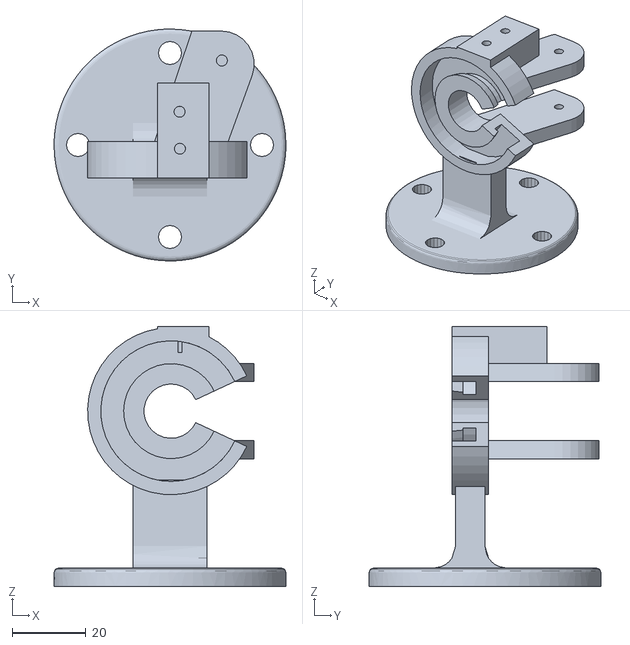
[picture p87: CAD file, 2016-05-16]
Attachments/Tool Adapters/Silly String Adapter/SillyStringAdapter2.obj
63.0 x 63.0 x 70.6
