CreativeInquiry/SCI-RAT-Attachments-for-UR5/Attachments/Tool Adapters/Tattoo Adapter/TattooAdapter2.stl

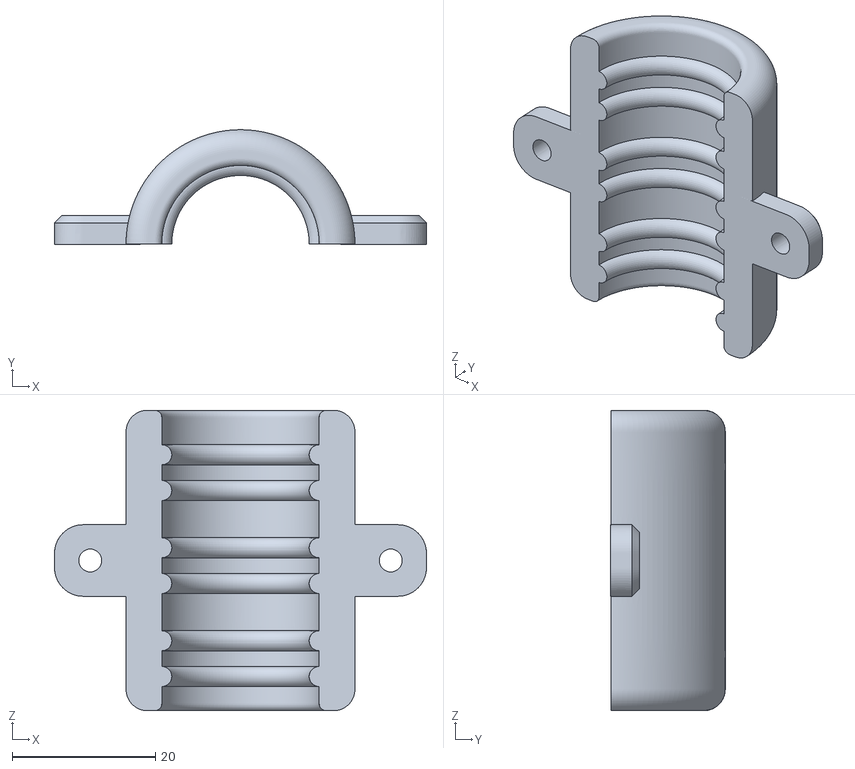
[picture p88: CAD file, 2016-05-16]
Attachments/Tool Adapters/Tattoo Adapter/TattooAdapter2.stl
52.0 x 16.0 x 42.0
