CreativeInquiry/SCI-RAT-Attachments-for-UR5/Attachments/Custom Hardware/Gripper Mount/Finger1.stl

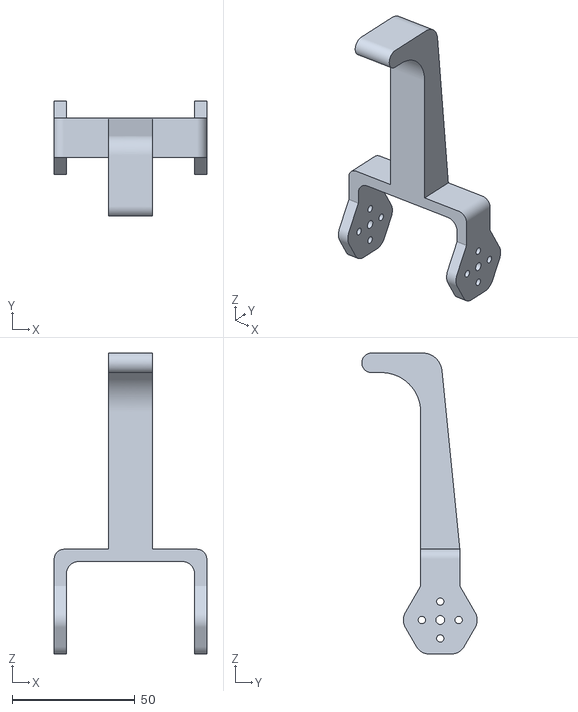
[picture p89: CAD file, 2016-05-16]
Attachments/Custom Hardware/Gripper Mount/Finger1.stl
62.2 x 47.1 x 122.7
