CreativeInquiry/SCI-RAT-Attachments-for-UR5/Attachments/Electronics Platforms/Enclosed Arduino Cube/ArduinoMount_1.stl

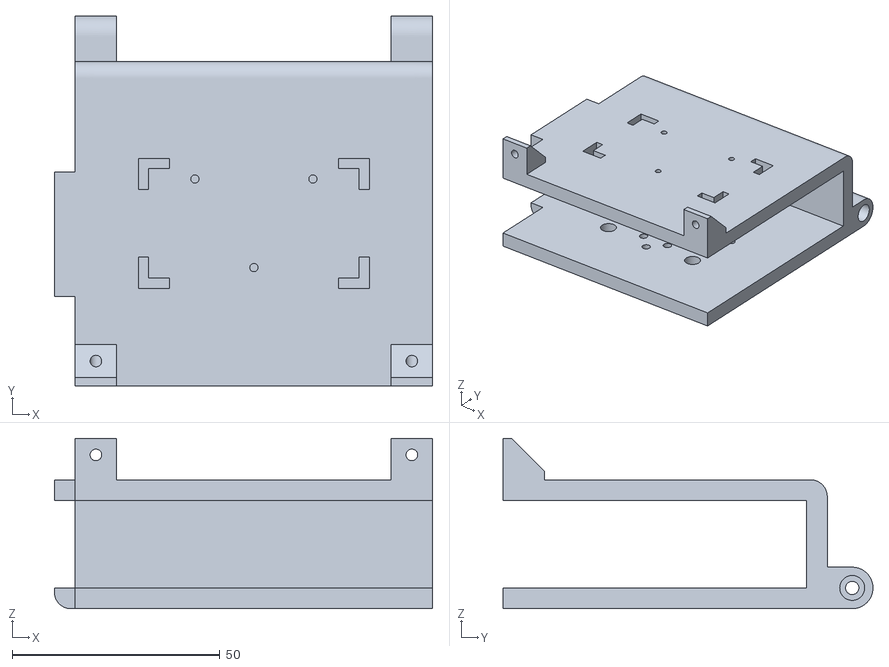
[picture p90: CAD file, 2016-05-16]
Attachments/Electronics Platforms/Enclosed Arduino Cube/ArduinoMount_1.stl
91.0 x 89.0 x 41.0
