CreativeInquiry/SCI-RAT-Attachments-for-UR5/Attachments/Googly Eyes/BigEye1_2.stl

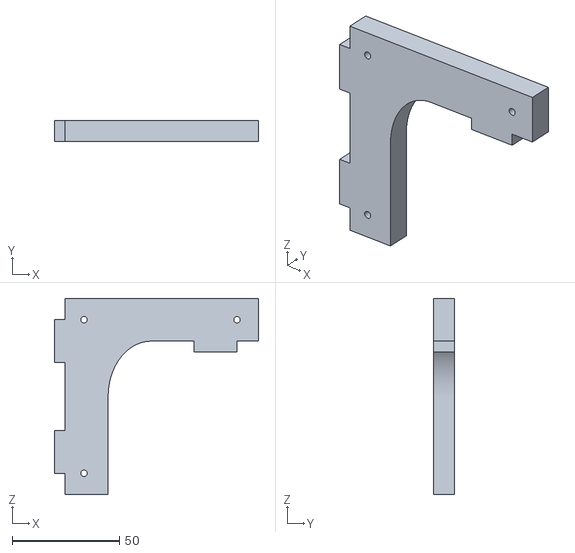
[picture p91: CAD file, 2016-05-16]
Attachments/Googly Eyes/BigEye1_2.stl
95.0 x 10.0 x 91.5
