CreativeInquiry/SCI-RAT-Attachments-for-UR5/Attachments/Miscellaneous/Microscope Project/1_8_ClearSheet.dxf

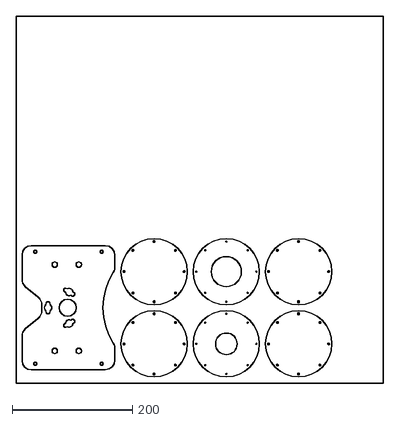
[picture p92: CAD file, 2016-05-16]
Attachments/Miscellaneous/Microscope Project/1_8_ClearSheet.dxf
609.6 x 609.6
