CreativeInquiry/SCI-RAT-Attachments-for-UR5/Attachments/Tool Adapters/Silly String Adapter/Servo_controlled_Silly-String_Trigger 2/StringFling.fcstd

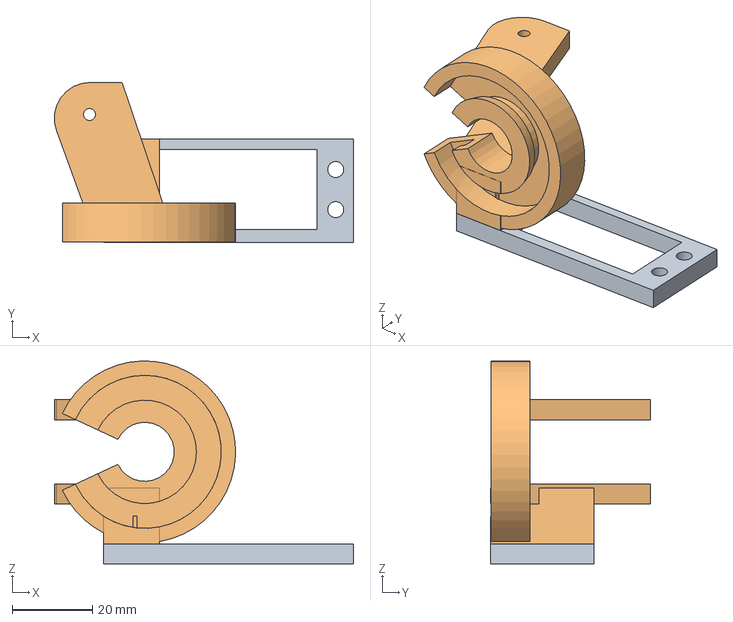
[picture p93: CAD file, 2016-05-16]
Attachments/Tool Adapters/Silly String Adapter/Servo_controlled_Silly-String_Trigger 2/StringFling.fcstd
74.6 x 40.0 x 50.7 mm
ServoPlate
