CreativeInquiry/SCI-RAT-Attachments-for-UR5/Attachments/Custom Hardware/Gripper Mount/Finger2.stl

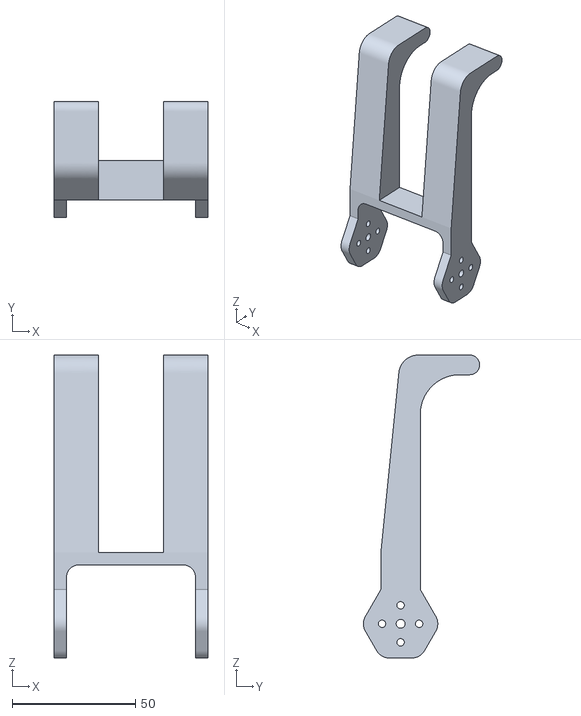
[picture p94: CAD file, 2016-05-16]
Attachments/Custom Hardware/Gripper Mount/Finger2.stl
62.2 x 47.1 x 122.7
