CreativeInquiry/SCI-RAT-Attachments-for-UR5/Attachments/Electronics Platforms/Enclosed Arduino Cube/ArduinoMount_2.stl

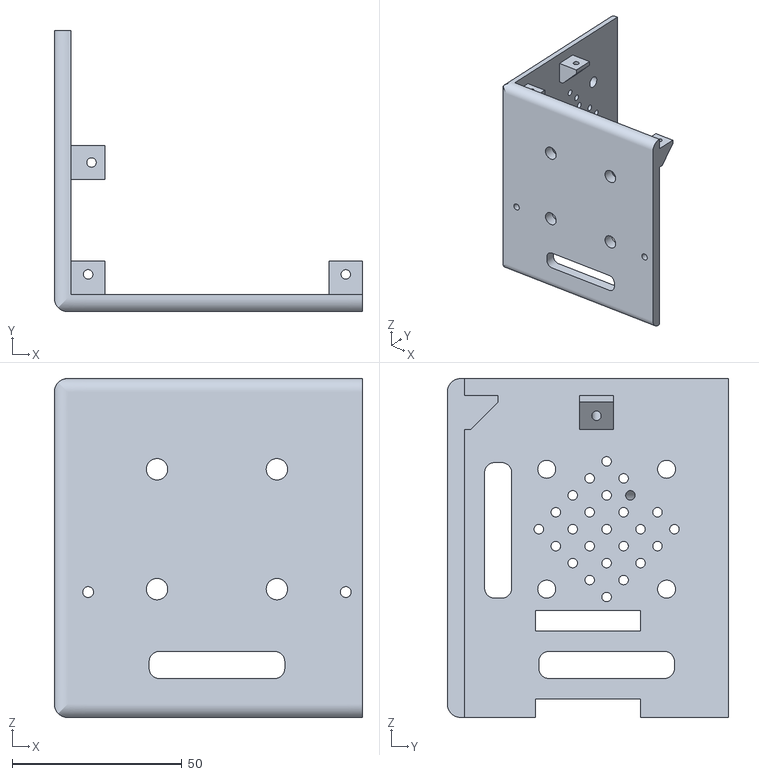
[picture p95: CAD file, 2016-05-16]
Attachments/Electronics Platforms/Enclosed Arduino Cube/ArduinoMount_2.stl
91.0 x 83.0 x 100.0
