CreativeInquiry/SCI-RAT-Attachments-for-UR5/Attachments/Googly Eyes/BigEye1_2_fixed.stl

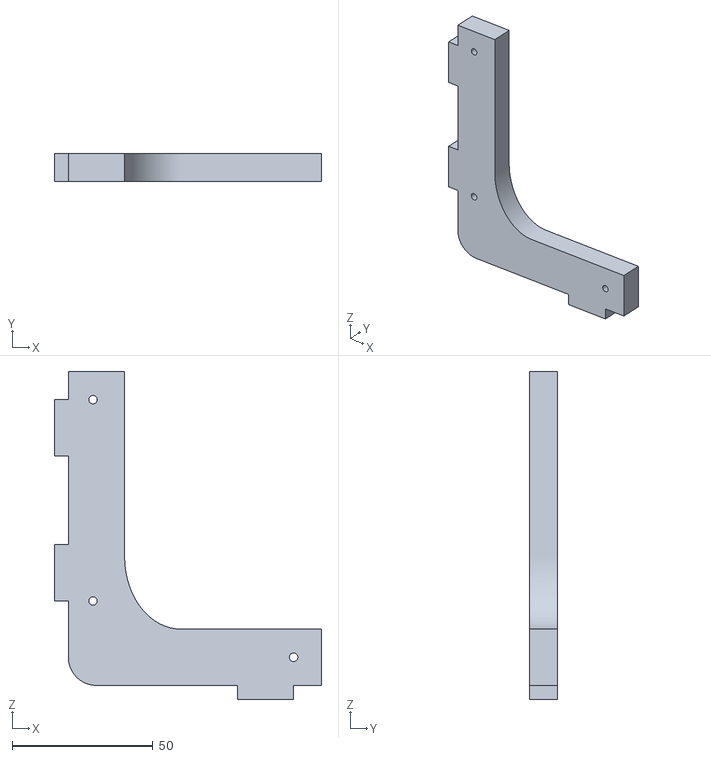
[picture p96: CAD file, 2016-05-16]
Attachments/Googly Eyes/BigEye1_2_fixed.stl
95.0 x 10.0 x 116.5
