CreativeInquiry/SCI-RAT-Attachments-for-UR5/Attachments/Tool Adapters/Silly String Adapter/Servo_controlled_Silly-String_Trigger 2/bracket_mount.stl

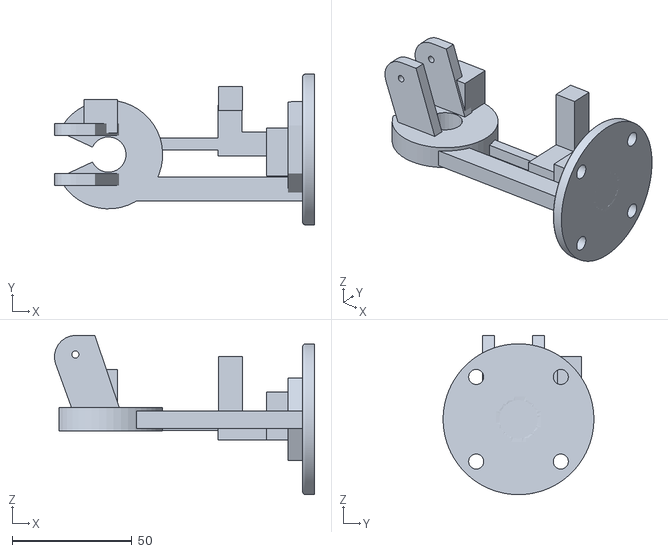
[picture p97: CAD file, 2016-05-16]
Attachments/Tool Adapters/Silly String Adapter/Servo_controlled_Silly-String_Trigger 2/bracket_mount.stl
108.7 x 63.0 x 66.5
