CreativeInquiry/SCI-RAT-Attachments-for-UR5/Attachments/Custom Hardware/Gripper Mount/GripperServoHolder.stl

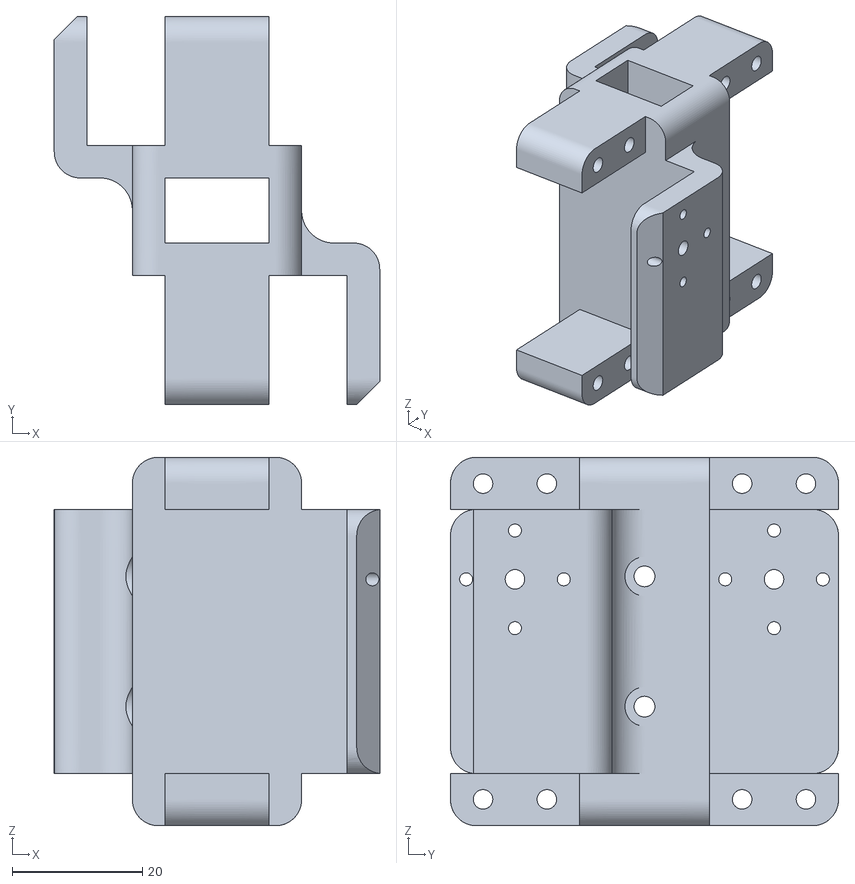
[picture p98: CAD file, 2016-05-16]
Attachments/Custom Hardware/Gripper Mount/GripperServoHolder.stl
50.0 x 59.6 x 56.6
