CreativeInquiry/SCI-RAT-Attachments-for-UR5/Attachments/Googly Eyes/BigEye1_3.stl

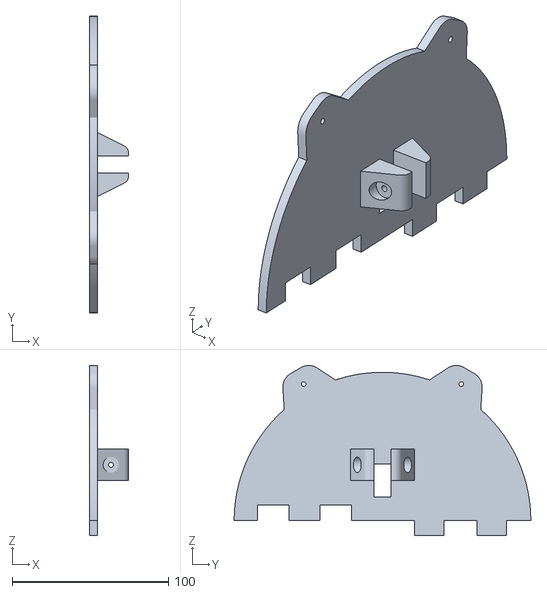
[picture p99: CAD file, 2016-05-16]
Attachments/Googly Eyes/BigEye1_3.stl
25.0 x 190.0 x 108.9
