CreativeInquiry/SCI-RAT-Attachments-for-UR5/Attachments/Tool Adapters/Silly String Adapter/Servo_controlled_Silly-String_Trigger 2/bracket.stl

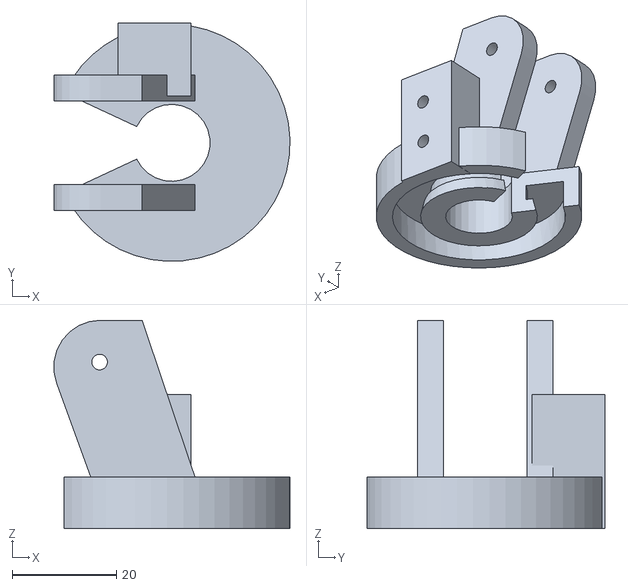
[picture p100: CAD file, 2016-05-16]
Attachments/Tool Adapters/Silly String Adapter/Servo_controlled_Silly-String_Trigger 2/bracket.stl
45.2 x 45.7 x 39.9
