CreativeInquiry/SCI-RAT-Attachments-for-UR5/Attachments/Custom Hardware/Gripper Mount/GripperMount.stl

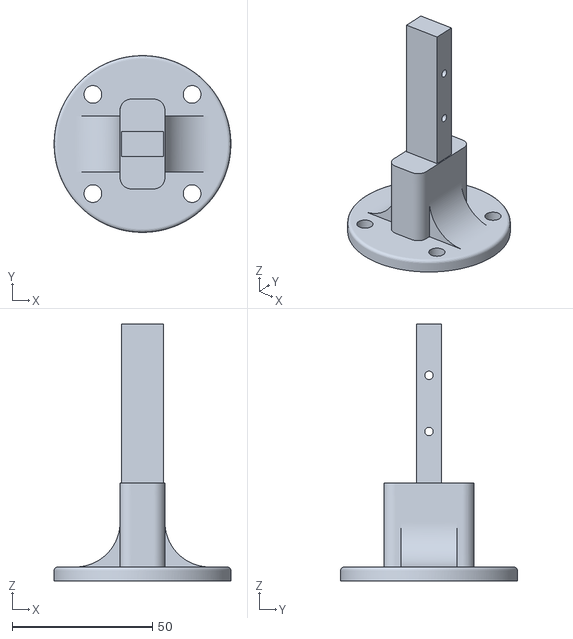
[picture p101: CAD file, 2016-05-16]
Attachments/Custom Hardware/Gripper Mount/GripperMount.stl
63.0 x 63.0 x 91.6
