CreativeInquiry/SCI-RAT-Attachments-for-UR5/Attachments/Googly Eyes/GooglyEye2_1.stl

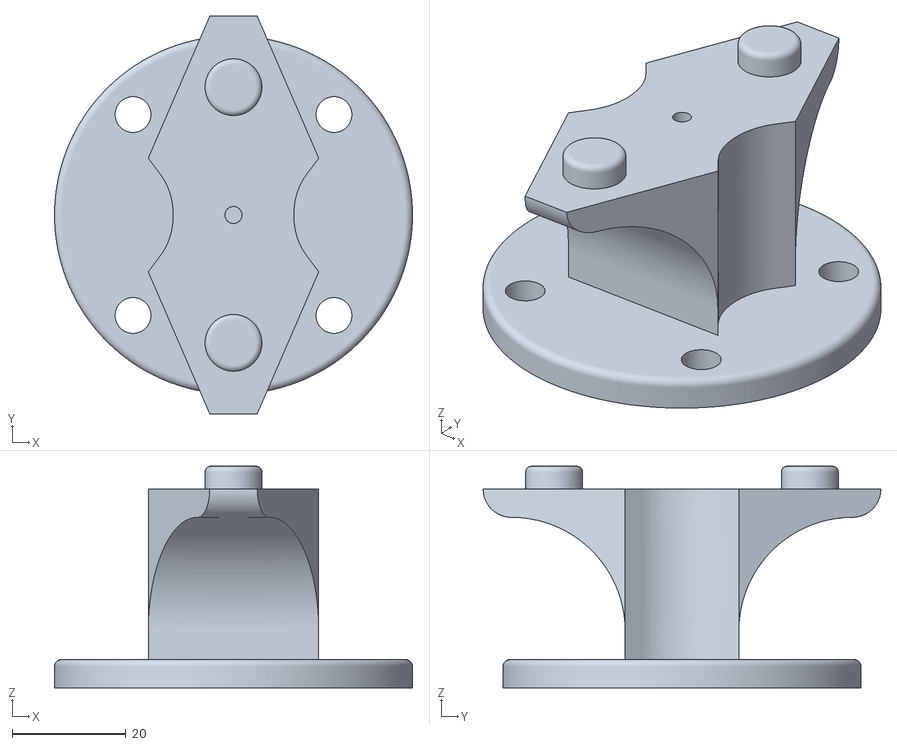
[picture p102: CAD file, 2016-05-16]
Attachments/Googly Eyes/GooglyEye2_1.stl
63.0 x 70.0 x 39.0
