CreativeInquiry/SCI-RAT-Attachments-for-UR5/Attachments/Googly Eyes/GooglyEye2_3.stl

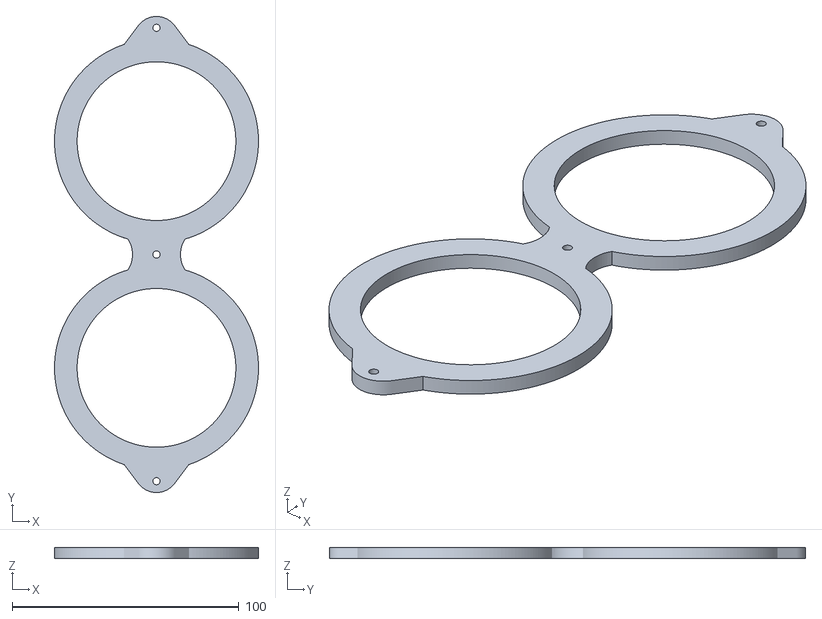
[picture p103: CAD file, 2016-05-16]
Attachments/Googly Eyes/GooglyEye2_3.stl
90.0 x 210.0 x 5.00
