CreativeInquiry/SCI-RAT-Attachments-for-UR5/Attachments/Googly Eyes/BigEye1_1.stl

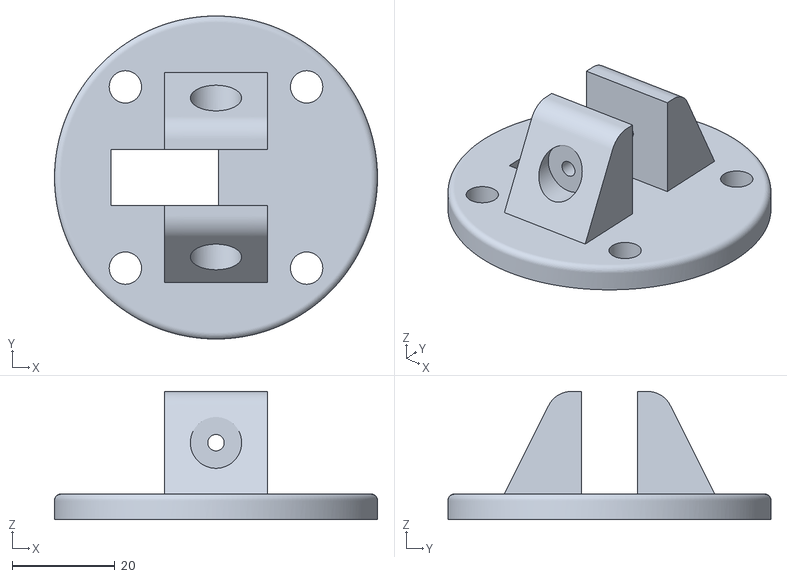
[picture p104: CAD file, 2016-05-16]
Attachments/Googly Eyes/BigEye1_1.stl
63.0 x 63.0 x 25.0
