CreativeInquiry/SCI-RAT-Attachments-for-UR5/(list of files, cad)

Other CAD files:
Attachments/Custom Hardware/Gripper Mount/GripperServoHolder2.stl
Attachments/Body Parts/FingerMount/Finger.3dm
Attachments/Body Parts/Head Mount/Head Mount.3dm
Attachments/Custom Hardware/CV Effector/Calibration Base.3dm
Attachments/Custom Hardware/Threading Hand/ThreadingMachine.3dm
Attachments/Electronics Platforms/Breadboard Mount/BreadBoardMount.3dm
Attachments/Miscellaneous/New Aluminum Mounting PLate/AluminumMountingPlate.3dm
Attachments/Miscellaneous/New Aluminum Mounting PLate/BasePlate.stl
Attachments/Miscellaneous/New Aluminum Mounting PLate/BasePlate.x_t
Attachments/Tool Adapters/Silly String Adapter/Improved Silly String Adapter.3dm
Attachments/Tool Adapters/Silly String Adapter/Servo_controlled_Silly-String_Trigger 2/bracket.obj
Attachments/Tool Adapters/Tattoo Adapter/TattooAdapter.3dm
