CreativeInquiry/SCI-RAT-Attachments-for-UR5/(commit log)

2016-05-16 Added Documentation for 15 Attachments in README.
2016-05-16 Revert "Added Documentation for 15 Attachments in README."
    This reverts commit e1fe3b94de985b3697decaa6fd160ae016c59f23.
2016-05-16 Added Images for All Attachments
    -1440x1080 images of all attachments.
2016-05-16 Added PDF Document of all attachments made over 2016.
    -Along with original Open Office file.
2016-05-16 Added main image with all attachments.
2016-05-16 Added CAD files to all attachments.
    -.x3g, .stl and .3dm files all included.
    [1_4_BlackSheet.dxf, 1_8_ClearSheet.dxf, 3030-S-1-CL.stp, AluminumMountingPlate.3dm, ArduinoMount_1.stl, ArduinoMount_2.stl, ArduinoMount_3.stl, ArduinoMount_4.stl]
2016-05-16 Added links to all attachments in list.
2016-08-04 Bill of Materials for Single Microscope Slider
    Bill of Materials for Single Microscope Slider
